mspenceree/Versa-Filter/hardware/README.md

# hardware

Schematic files in PDF and OrCAD (v10.3) format and Bill-of-Materials files in Microsoft Excel.
