mspenceree/Versa-Filter/hardware/BOM filter module.xls

Versa-Filter Module (Rev. B), Stock as of 5/23/2001
# Modules= |  |  | 100
 | pcs./ | pcs. | in stock |  |  |  |  |  |  | Quantity
Line | Mod. | total | at SPS | Ref. | Description | Manufacturer | Part# (if not in Desc.) | Distributor | Part# | Ordered | Price | Extended
1 | 4 | 400 | OK, in system | C1-4 | 10uF, 6.3V, Tantalum Chip Cap., Size 1206 | Panasonic | ESC-TOJY106R | Digi_Key | PCS1106CT orTR |  | 0.335 | $133.92
2 | 12 | 1200 | OK, in system | C5-16 | 0.1uF, 25V, +80, -20%, Chip Cap., Size 0603 | muRata | GRM39Y5V104Z025AD | Newark |  |  | 0.012 | $14.40
4 | 1 | 100 | >500 | J1 | IO_CONNECTOR (Custom break-away header) |  |  |  |  |  | 0.000 | $0.00
5 | 1 | 100 |  | J2 | JTAG_HEADER, 14 pin dual row header, gold (optional) |  |  | Digi_Key | S2011-36 |  |  | $0.00
6 | 1 | 100 | 100+68 | L1 | Ferrite Bead, 500mA, 600 Ohms, Size 0805 | Steward | HZ0805E601R | Digi_Key | 240-1018-1 |  | 0.069 | $6.93
8 | 1 | 100 | ~4000 | R1 | 100K, 1/16W, 5%, Chip Resistor, Size 0603 | Panasonic |  | Digi_Key | P100KGCT orTR |  | 0.015 | $1.50
9 | 3 | 300 | OK, in system | R2,3,RA | 10K, 1/16W, 5%, Chip Resistor, Size 0603 | Panasonic |  | Digi_Key | P10KGCT orTR |  | 0.013 | $4.05
10 | 1 | 100 | 119 | R4 | 2.2 Ohm, 1/10W, 5%, Chip Resistor, Size 0805 | Panasonic | ERJ-6RQJ2.2V | Digi_Key | P2.2BCT orTR |  | 0.112 | $11.20
12 | 1 | 100 | 105 | DA | Schottky Diode, 20V, 400mW, SMD | Diodes Inc. | SD103-CW | Digi_Key | SD103-CWDICT |  | 0.480 | $48.00
14 | 1 | 100 | ~370 | U5 | 12.288MHz Oscillator Module (SMD) | Epson | SG-636PCE-12.288MC2 | Digi_Key | SE2823CT orTR |  | 3.750 | $375.00
15 | 1 | 100 | 100+1 | U1 | TMS320C203PZ57 PZA57 or PZ80 OK, (TQFP), 16 bit DSP |  |  | Wyle |  |  | 7.680 | $768.00
16 | 1 | 100 | 64+37 | U2 | Am29F010-120EC (TSOP), 128K x 8 FLASH | AMD |  | Future | Avnet $3.90 |  | 3.500 | $350.00
17 | 2 | 200 | 205 | U3,U4 | IDT71256SA15PZ (TSOP), 32K x 8 SRAM | IDT |  | Insight |  |  | 3.000 | $600.00
18 | 1 | 100 | 101 | U6 | CS4218-KQ (TQFP), Stereo CODEC | Crystal |  | Insight |  |  | 7.000 | $700.00
19 | 1 | 100 | 110+36+1 | U7 | 74F00 (SOIC), Quad NAND gate | Fairchild, TI |  | Future | 74F00SC |  | 0.150 | $15.00
20 | 1 | 100 | 110+37+1 | U8 | 74ACT32 (SOIC), Quad OR gate | Fairchild, TI |  | Future | 74ACT32SC |  | 0.150 | $15.00
21 | 1 | 100 | 70+35+1 | U9 | 74FCT2652 (QSOP), Octal Reg. Transceiver | IDT, Pericom |  | Future | PI74FCT2652ATQ |  | 0.930 | $93.00
 |  |  |  |  |  |  |  |  |  |  |  | $0.00
23 | 1 | 100 | 400 |  | Blank PC Board | Valley Circuits, (818) 897-2006 |  |  |  |  | 8.000 | $800.00
24 | 1 | 100 | OK |  | Epoxy Compound | 3M | DP-270 black, 200ml |  |  |  | 2.500 | $250.00
 |  |  |  |  |  |  |  |  | Parts Total: |  |  | $4186.00
 |  |  |  |  |  |  |  |  | Parts Each Module: |  |  | $41.86
29 | 1 | 100 |  |  | PC board assembly cost (labor) |  |  |  |  |  | 6.900 | $690.00
30 | 1 | 100 |  |  | Final assembly cost (potting and labeling) |  |  |  |  |  | 20.000 | $2000.00
31 | 1 | 100 |  |  | Programming and Test cost (labor) |  |  |  |  |  | 30.000 | $3000.00
Rev. B Assembly notes: |  |  |  |  |  |  |  |  | Assembly Total: |  |  | $5690.00
1. Bake ICs to remove moisture as directed on packaging as necessary |  |  |  |  |  |  |  |  | Assembly Each Module: |  |  | $56.90
2. Trim plastic package of U3 or U4 so that pins will line up (if necessary)
3. Add 10K resistor (RA) from J2-pin 2 to J2-pin 4 (keep away from board edge) |  |  |  |  |  |  |  |  | Grand Total: |  |  | $9876.00
4. Add Schottky diode (DA) (SD103-CW) from top of C5 to top of R1 (cathode (line) to C5) |  |  |  |  |  |  |  |  | Each Module: |  |  | $98.76
5. Add jumper from W1-pad (near U2) to J1-pin 14
6. Add jumper from W2-pad (near U2) to J1-pin 18
7. Solder 28 pin IO connectors using supplied stand to assure alignment
