mspenceree/Versa-Filter/hardware/BOM filter system chassis.xls

Chassis Parts List for 2-Channel System (Rev. B), Stock as of 2/2001
# Systems = |  |  | 47
 | pcs./ | pcs. | in stock |  |  |  |  | Quantity
Line | each | total | at SPS | Description | Manufacturer & Part # | Distrib. | Part# | Ordered | Price | Extended
1 | 1 | 47 | 47 | Chassis box without panels | Elma (510) 656-0606, 33-05418-00 |  |  |  | 56.610 | $2660.67
2 | 1 | 47 | 97 | Front Panel, custom punched | Cresent Metal Products, (323) 465-1171 |  |  |  | 7.180 | $337.46
3 | 1 | 47 | 97 | Rear Panel, custom punched | Cresent Metal Products, (323) 465-1171 |  |  |  | 3.150 | $148.05
4 | 4 | 188 | 388 | 6-32 x 1/4" pan head screws (for PCB mounting) |  |  |  |  | 0.050 | $9.40
5 | 2 | 94 | 254 | 4-40 x 3/8" round head Philips screws (for power connector) |  |  |  |  | 0.050 | $4.70
6 | 2 | 94 | 294 | 4-40 nuts (for power connector) |  |  |  |  | 0.050 | $4.70
7 | 2 | 94 | >200 | 4-40 lock washers (for power connector) |  |  |  |  | 0.050 | $4.70
8 | 1 | 47 | 100+8 | DB-9F panel mount | AMP | Digi-Key | 209F |  | 0.520 | $24.44
9 | 1 | 47 | 100+9 | DB-9M panel mount | AMP | Digi-Key | 209M |  | 0.490 | $23.03
10 | 2 | 94 | 200+9 | Female screw locks for DB-9's (kit with nuts) | AMP | Digi-Key | A9005 |  | 1.050 | $98.70
11 | 1 | 47 | 100+5 | Power Switch | C&K, D502J125215SPQF | Digi-Key | CKC2010 |  | 0.360 | $16.92
12 | 1 | 47 | 100+5 | Power Connector, 5-pin DIN | CUI Stack, SD-50SN | Digi-Key | CP-1250 |  | 0.700 | $32.90
13 | 3 | 141 | 340 | 1N4005, 1A, 600V Diodes (reverse polarity protection) |  | Digi-Key | 1N4005GICT |  | 0.036 | $5.08
14 | 1 | 47 | OK | Hookup wire, #22AWG (7/30),3-whites,1-red,1-black,1-green,1-blue (7-wires, 14" each) |  | Digi-Key | A2016W-100 |  | 1.200 | $56.39
15 | 1 | 47 | 10 | Power Pack 115VAC to regulated 5V,-12V,+12V | Elpac, WM063-1950 | Digi-Key | EPS142 |  | 34.030 | $1599.41
16 | 1 | 47 | 51 | RS-232 cable, DB-9M to DB-9F |  | Digi-Key | AE1021 |  | 6.010 | $282.47
17 | 1 | 47 | 174 | Front panel adhesive labels | Adhesa Plate (800) 634-9701), AP16316 |  |  |  | 7.750 | $364.25
18 | 1 | 47 | 181 | Rear panel adhesive labels | Adhesa Plate (800) 634-9701), AP17398 |  |  |  | 4.200 | $197.40
19 | 4 | 188 | 78 | 6-32 x 1/2" standoffs (for PCB mounting. 8 and 32 ch systems only) |  | Mouser | 534-2210 |  |  | $0.00
20 | 4 | 188 | 49 | 6-32 x 1/4" flat head screws (for panel standoffs. 8 and 32 ch systems only) |  |  |  |  |  | $0.00
21
22 | 1 | 47 | - | Assembly cost (chassis wiring labor) |  |  |  |  | 4.000 | $188.00
23 |  |  |  |  |  |  | Chassis Total: |  |  | $6058.66
24 |  |  |  |  |  |  | Each System: |  |  | $128.91
