mspenceree/Versa-Filter/hardware/BOM filter system.xls

2-Channel Versa-Filter System ( Rev. B), Stock as of 2/2001
# of Boards = |  |  | 98
 | pcs./ | pcs. | in stock |  |  |  |  |  | Quantity
Line | each | total | at SPS | Reference | Description | Manufacturer & Part # | Distrib. | Part# | Ordered | Price | Extended
1 | 4 | 392 | 4000+5 | C18,23,28,33 | 100pF, Size 0603 |  | Digi-Key | PCC101ACVCT |  | 0.019 | $7.45
2 | 2 | 196 | 204+4 | C20,30 | 470pF, Size 0603 |  | Allied | 213-0185 |  | 0.297 | $58.21
3 | 2 | 196 | 198 | C19,29 | 2200pF, Size 0603 |  | Allied | 213-1514 |  | 0.182 | $35.67
4 | 4 | 392 | 500+3 | C4,5,7,35* | 0.01uF, Size 0603 (C35 is for serial port fix) |  | Digi-Key | PCC103BVCT |  | 0.132 | $51.74
5 | 14 | 1372 | 4000+~1000 | C9*,10*,11*,12,13*,14*,15,16,21,24,25,26,31,34 | 0.1uF, Size 0603 |  |  |  |  | 0.012 | $16.46
6 | 2 | 196 | 196 | C22,32 | 0.1uF 10%, Size 1206 or 1210 |  | Allied | 213-0185 |  | 0.594 | $116.42
7 | 2 | 196 | 216 | C17,27 | 1.8uF, 16V, Size 1206 or 1210 |  | Digi-Key | PCC???CT |  | 0.562 | $110.25
8 | 2 | 196 | 1475+4 | C6,8* | 10uF, 6.3V, Size 1206 or 1210 |  | Digi-Key | PCS1106CT |  | 0.480 | $94.08
9 | 2 | 196 | 246 | C1,2 | 68uF, 16V, Size 7.3 x 4.3 mm |  | Allied | 926-0411 |  | 1.870 | $366.52
10 | 1 | 98 | 98 | C3 | 100uF, 6.3V, Size 7.3 x 4.3 mm |  | Allied | 213-1074 |  | 1.584 | $155.23
11
12 | 1 | 98 | 202 | R10 | 10.2, 1/8W, 1%, Resistor, Size 1206 |  | Digi-Key | P10.2FCT |  | 0.126 | $12.35
13 | 3 | 294 | 1000+44 | R3,17,29 | 100, 1/16W, 1%, Resistor, Size 0603 |  | Digi-Key | P100HCT |  | 0.126 | $37.04
14 | 2 | 196 | 300+4 | R8,9 | 221, 1/16W, 5%, Resistor, Size 0603 |  | Digi-Key | P221HCT |  | 0.126 | $24.70
15 | 2 | 196 | 300 | R20,32 | 2K, 1/16W, 1%, Resistor, Size 0603 |  | Digi-Key | P2.00KHCT |  | 0.126 | $24.70
16 | 12 | 1176 | 1850+~1000 | R1,2,4,5,6,7,11*,12*,16,23,28,35 | 10K, 1/16W, 1%, Resistor, Size 0603 |  | Digi-Key | P10.0KHCT |  | 0.126 | $148.18
17 | 4 | 392 | 1000+7 | R15,18,27,30 | 20K, 1/16W, 1%, Resistor, Size 0603 |  | Digi-Key | P20.0KHCT |  | 0.126 | $49.39
18 | 4 | 392 | 1000+5 | R14,22,26,34 | 68.1K, 1/16W, 1%, Resistor, Size 0603 |  | Digi-Key | P68.1KHCT |  | 0.126 | $49.39
19 | 4 | 392 | 1000+4 | R13,21,25,33 | 169K, 1/16W, 1%, Resistor, Size 0603 |  | Digi-Key | P169KHCT |  | 0.126 | $49.39
20 | 2 | 196 | 300+3 | R24,36 | 301K, 1/16W, 1%, Resistor, Size 0603 |  | Digi-Key | P301KHCT |  | 0.126 | $24.70
21 | 2 | 196 |  | R19,31 | Rg, 1/16W, 1%, Resistor, Size 0603 (optional) |  |  |  |  |  | $0.00
22 | 1 | 98 | 98+4 | RP1 | 10K trim pot | Bourns 3329H-1-103 | Digi-Key | 3329H-103 |  | 1.323 | $129.65
23
24 | 2 | 196 | 200+51 | D1,5* | Dual Schottky (com. cathode) SOT-23 |  | Digi-Key | BAT54CCT |  | 0.930 | $182.28
25 | 1 | 98 | 100+5 | D4 | Dual Schottky (com. anode) SOT-23 |  | Digi-Key | BAT54ACT |  | 0.930 | $91.14
26 | 2 | 196 | 200+8 | D2,3 | LED's, 3.7mm, Red | HLMP-1301 | Allied | 782-0015 |  | 0.297 | $58.21
27
28 | 1 | 98 | 95 | U1* | MAX232ACSE, SO-16 | Maxim | Digi-Key | MAX232ACSE |  | 1.230 | $120.54
29 | 2 | 196 | 200+2 | U3,5 | Instrumentation Amp (INA128or129),SO-8 | Burr Brown | Digi-Key | INA128U |  | 3.620 | $709.52
30 | 2 | 196 | 201 | U4,6 | Dual Op Amp (OPA2134), SO-8 | Burr Brown | Digi-Key | OPA2134UA |  | 2.670 | $523.32
31
32 | 4 | 392 | 393 | J2,3,5,6 | BNC Vertical Mount | A/D Electronics (253) 851-8005, 581-002-00 |  |  |  | 2.500 | $980.00
33 | 1 | 98 | 7 | P1 (note 1) | DB-9F PC board Mount |  | Digi-Key | 509F |  | 1.930 | $189.14
34 | 1 | 98 | 6 | P2 (note 1) | DB-9M PC board Mount |  | Digi-Key | 509M |  | 1.340 | $131.32
35 | 1 | 98 | OK | - | Header for mounting LC Display (15 pin) |  | Digi-Key | S1212-15 |  | 0.030 | $2.94
36 | 2 | 196 | OK | JP2,4 | Jumper header (2 pin) (Use strips of 36 pins and cut) |  | Digi-Key | S1212-36 |  | 0.071 | $13.94
37 | 2 | 196 | OK | JP3,5 | Jumper header (3 pin) ( " ) |  | Digi-Key | S1212-36 |  | 0.107 | $20.91
38 | 4 | 392 | 406 | - | Shorting Jumpers |  | Digi-Key | S9000 |  | 0.093 | $36.46
39 | 2 | 196 | 63 | J1,4 (note 2) | 1/4 inch Phone Jack | SwitchCraft | Digi-Key | SC1096 |  | 1.711 | $335.36
40 | 1 | 98 | 100+4 | LS1 | Loud Speaker | Panasonic, EAF-14R06C | Digi-Key | P9922 |  | 3.610 | $353.78
41 | 1 | 98 | 98 | S1 | Rotory Encoder with SW (15puls, 30 det) | Switch Channel (323) 221-8876, RE11CT-V1Y12-EF2CS |  |  |  | 1.290 | $126.42
42 | 1 | 98 | 12 | M1 | Versa-Filter Module | SPS, VF20-2 ($495 retail) |  |  |  | 100.00 | $9800.00
43 | 1 | 98 | 98+3 | U2 | LC Display (16 character x 1 line) | Apollo Display (888) 452-3937, Oprex, DMC-16105NY-LY (or Digi-Key 73-1018) |  |  |  | 14.680 | $1438.64
44 | 1 | 98 | 129 | - | Versa-Filter module socket-leave spacing | SAMTEC, BCS-128-L-S-HE |  |  |  | 2.373 | $232.55
45 | 1 | 98 | 64 | - | Knob & Cap (for rotory encoder) | Selco (714)-712-6200, DA210-006BLACK & C210BLACK |  |  |  | 0.960 | $94.08
46 | 1 | 98 | 198 | - | Blank PC Board | Valley Circuits, (818) 897-2006 |  |  |  | 7.00 | $686.00
47 |  |  |  |  |  |  |  | Parts Total: |  |  | $17688.07
48 |  |  |  |  |  |  |  | Parts Each Board: |  |  | $180.49
49
50 | 1 | 98 | - |  | PC board assembly cost (labor) |  |  |  |  | $10.00 | $980.00
51 | 1 | 98 | - |  | Testing cost (labor) |  |  |  |  | $20.00 | $1960.00
52 |  |  |  |  |  |  |  | Assembly Total: |  |  | $2940.00
53 |  |  |  | * - RS-232 related circuits (required for Evaluation board and 2ch. Versa-Filter System board) |  |  |  | Assembly Each Board: |  |  | $30.00
54 |  |  |  | note 1 - DB-9s required for Evaluation board only (not on 2ch. Versa-Filter System board)
55 |  |  |  | note 2 - Differential input connectors (option) |  |  |  | Grand Total: |  |  | $20628.07
56 |  |  |  |  |  |  |  | Total Each Board: |  |  | $210.49
