mspenceree/Versa-Filter/(list of files, cad)

Other CAD files:
firmware/builds/FILTASM.OBJ
firmware/builds/FILT.OBJ
