mspenceree/Versa-Filter/hardware/filter_module.pdf

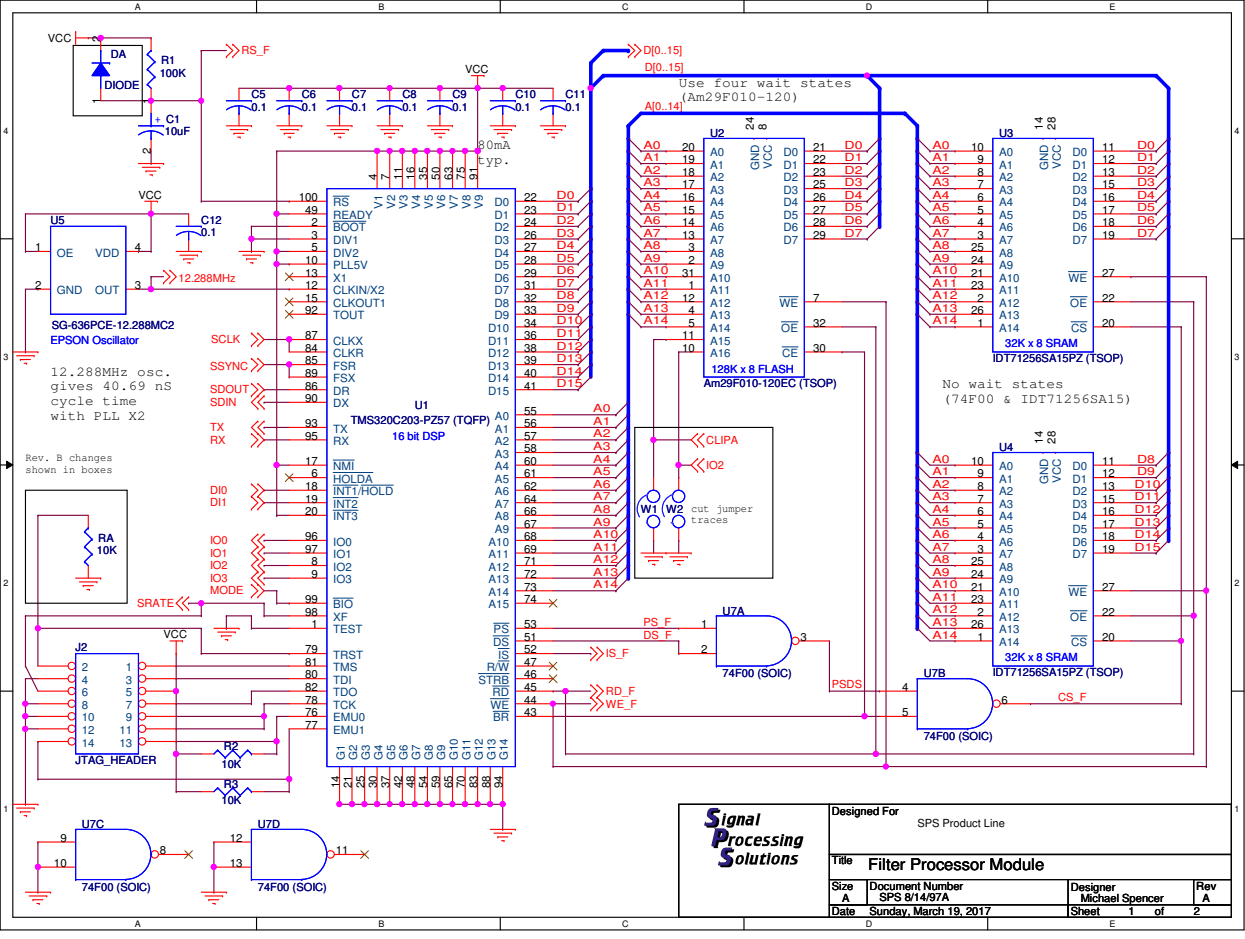
[picture p5: page 1]

Use four wait states

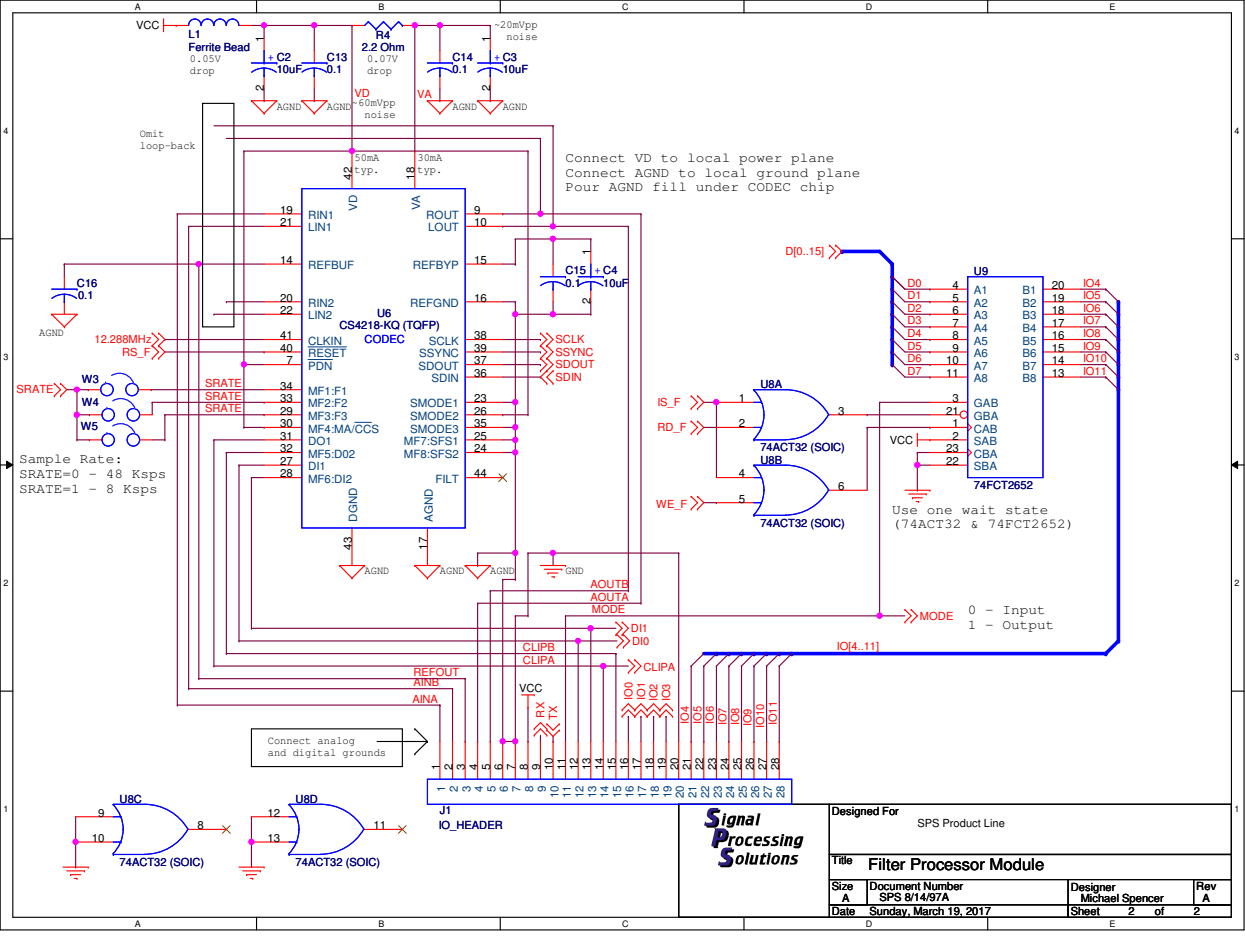
[picture p6: page 2]

Connect VD to local power plane
Connect AGND to local ground plane
Pour AGND fill under CODEC chip

Use one wait state
(74ACT32 & 74FCT2652)

GND AOUTB

AOUTA

CLIPB
CLIPA
