mspenceree/Versa-Filter/hardware/filter_system.pdf

# Versa-Filter Module

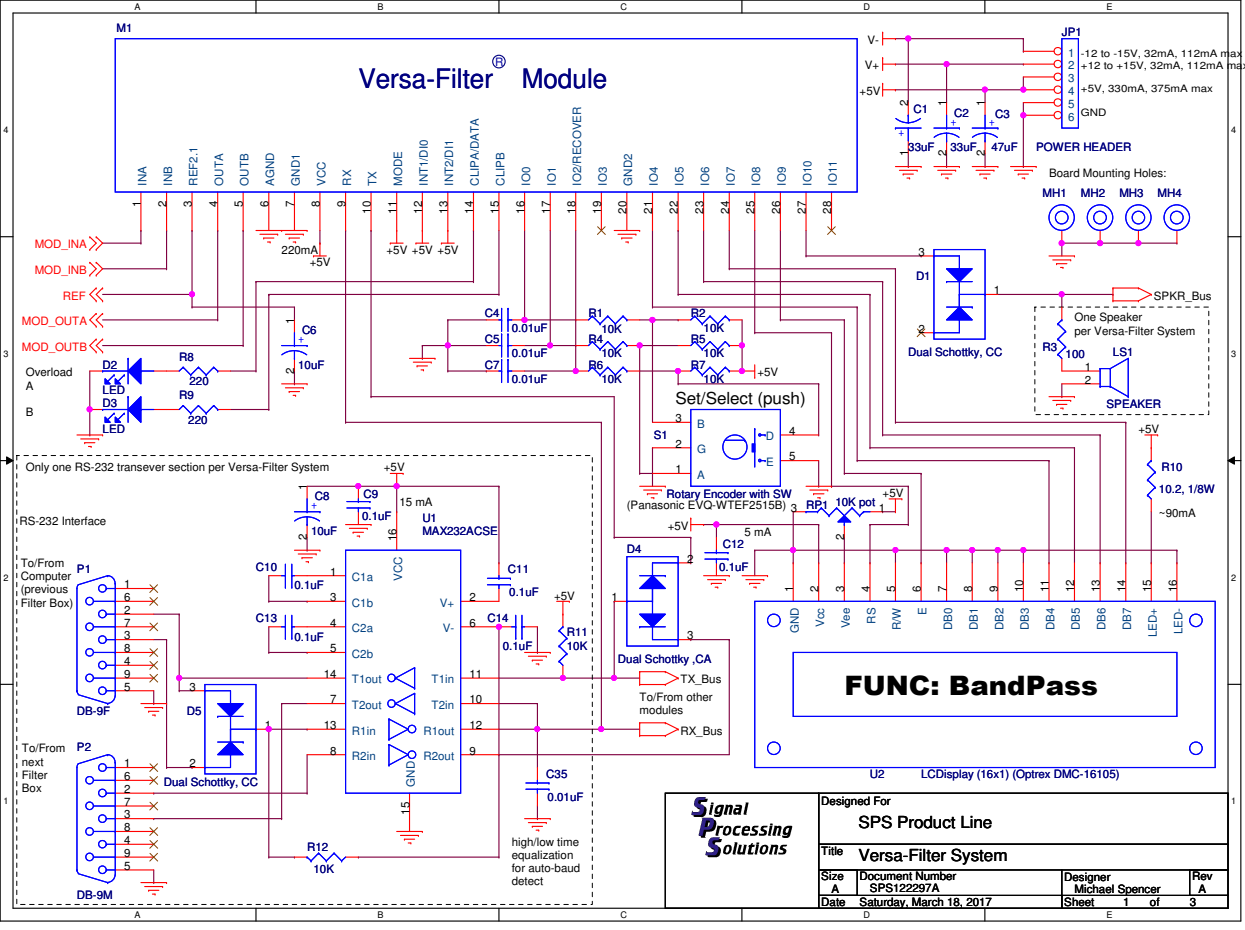
[picture p7: page 1]

Board Mounting Holes:

One Speaker
per Versa-Filter System

Only one RS-232 transever section per Versa-Filter System

V+V-

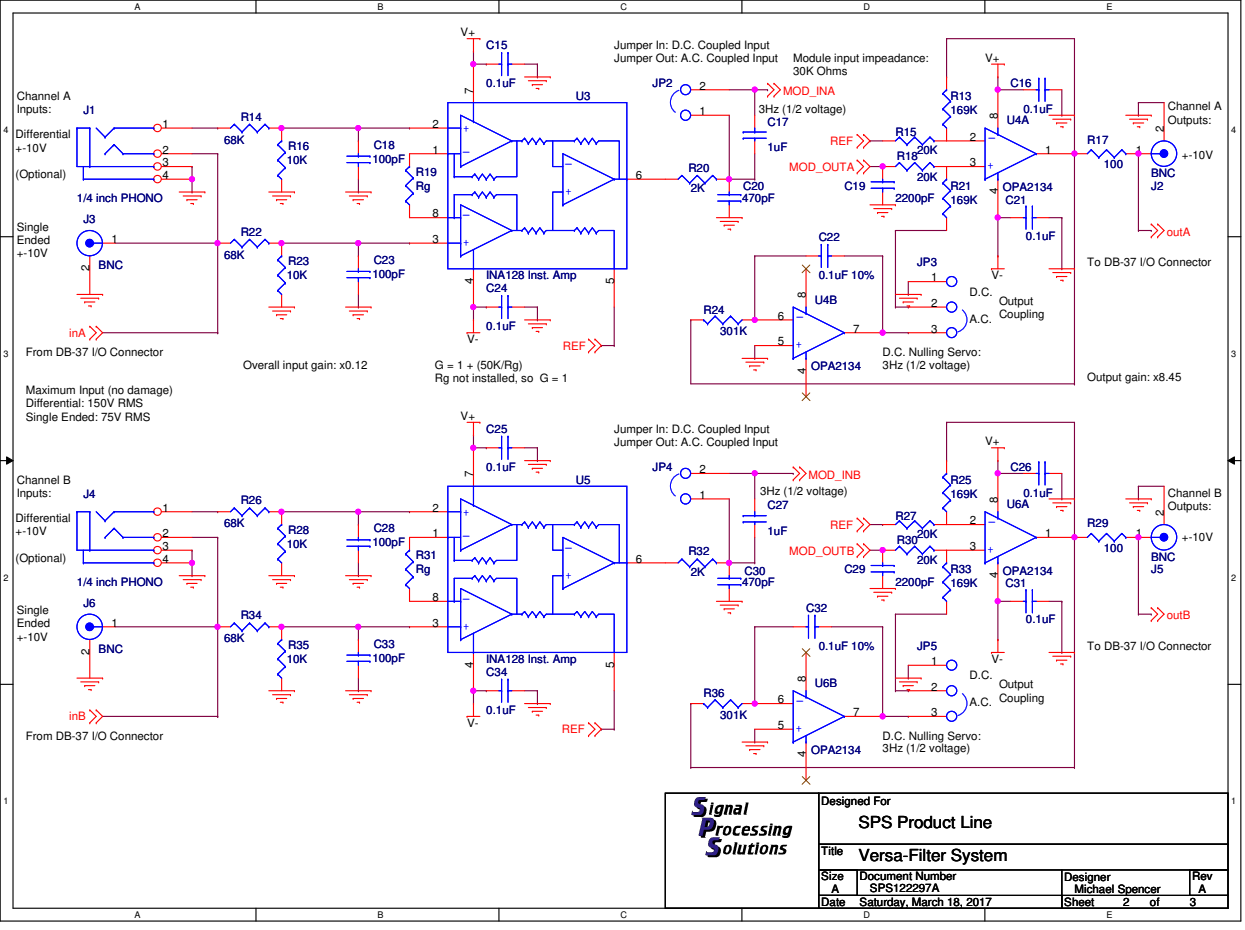
[picture p8: page 2]

Jumper In: D.C. Coupled Input
Jumper Out: A.C. Coupled Input

Rg not installed, so G = 1

Maximum Input (no damage)
Differential: 150V RMS
Single Ended: 75V RMS

inA1 inA3 inA5 inA7 inA9 inA11 inA13 inB1 inB3 inB5 inB7 inB9 inB11 inA15 inB13 inB15 outA outB outA3 outA5 outA7

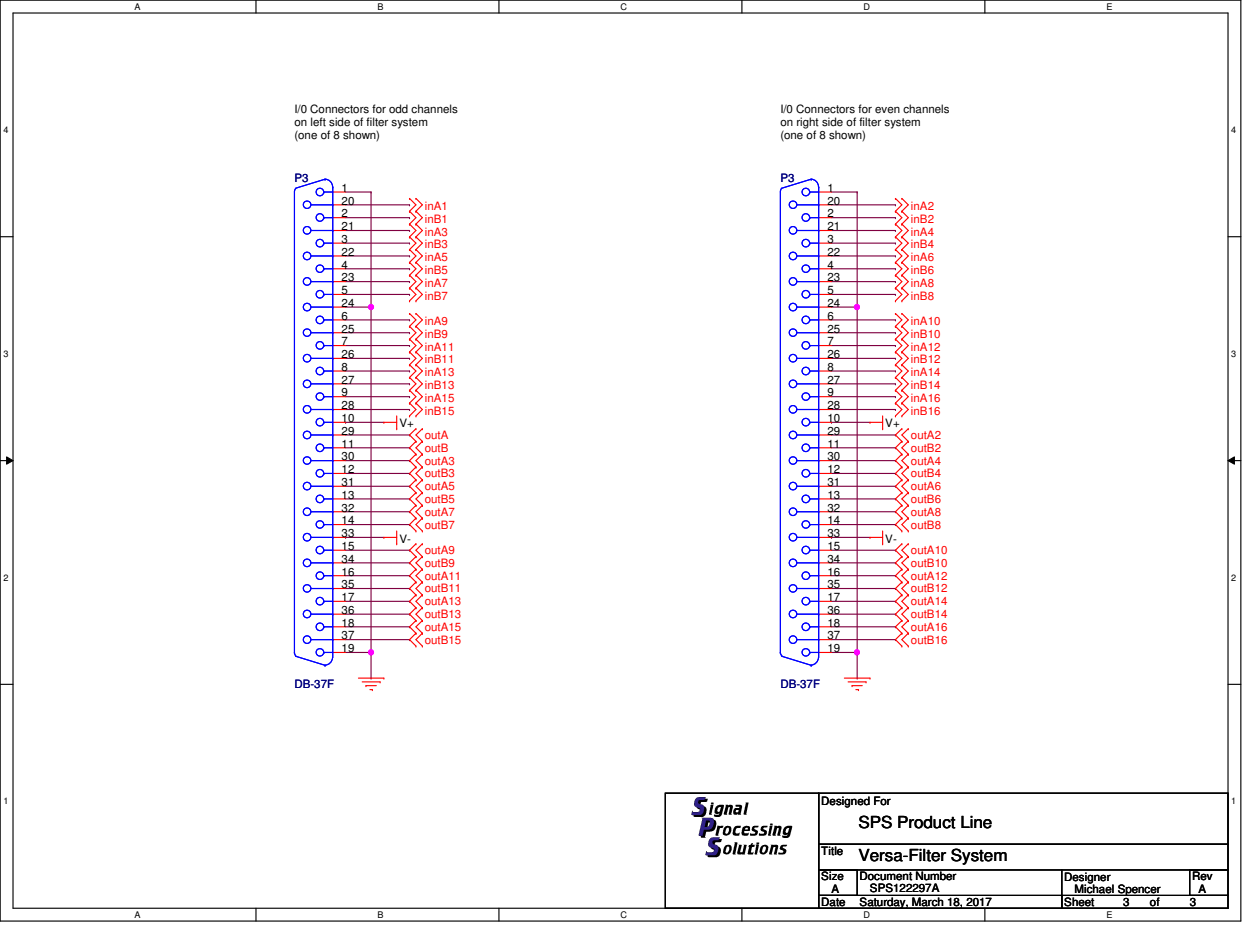
[picture p9: page 3]
outA9; outA11; outA13; outA15; outB3; outB5; outB7; outB9; outB11; outB13; outB15; inA2; inA4; inA6; inA8; inA10; inA12; inA14; inB2; inB4; inB6; inB8; inB10; inB12; inA16; inB14; inB16; outA2 outB2 outA4; outA6; outA8; outA10; outA12; outA14; outA16; outB4; outB6; outB8; outB10; outB12; outB14; outB16; Size; Document Number; Rev; Designer; Saturday, March 18, 2017

I/0 Connectors for odd channels
on left side of filter system
(one of 8 shown)

I/0 Connectors for even channels
on right side of filter system

Designed For
SPS Product Line

Title
Versa-Filter System
