mspenceree/Versa-Filter/(list of files, drawings)

Other design files:
hardware/FILTER_MODULE.DSN
hardware/FILTER_SYSTEM.DSN
