mspenceree/Versa-Filter/firmware/filt.c

/**************************************************************************
 *
 *  filt.c source file
 *
 *  This c source file contains code for the filter module.
 *  It performs initialization, sets up ISRs and enters main loop and
 *  flashes cursor until action is required.
 *
 *  History:
 *  V1.00   10/3/97 Started coding orignial - Michael Spencer
 *  V1.01 to V1.60  Lots of additions and modifications...
 *  V1.61   1/24/99 Commented out the command display test lines
 *  V1.62   1/31/99 Fixed the "valid_serial()" func. to compute correct check sums
 *  V1.63   2/6/99  Added the "display:" option that brings back the normal display
 *  V1.64   2/9/99  Added serial command interface
 *  V1.65   2/28/99 Re-aranged sign-on message so recall 0 is not delayed
 *  V1.66   3/13/99 Added display of UserFIR coefs.
 *  V1.67   3/14/99 Added value checking on RS-232 paramters
 *  V2.00   4/26/00 Added calibration msg. This is the feature complete version.
 *  V2.10   4/26/00 Added support for alternate (direction reversed) rotary encoder.
 *  V2.20   6/8/01  Fixed error in parser that updates min_value and max_value limits (param_ptr_temp).
 *                  Removed "Calibrate". Added "Erase Mem".
 *
 **************************************************************************/

/******* Build Parameters *************************************************/
#define MAIN 1              /* 1 - builds main (normal) version of Firmware */
                            /* 0 - builds recovery version of Firmware with */
                            /*     with only serial port programming support */
#define ENCODER_TYPE    1   /* Rotary encoder type: 0 - panasonic, 1 - Switch Channel */
#define SIGN_ON_FLAG_Versa_Filter   1   /* set to one for standard sign on message */
#define SIGN_ON_FLAG_AccuQuest      0   /* set to one for AccuQuest sign on message */

/******* Program Parameters ***********************************************/
#define VERSION 220             /* Firmware Version # (3 digit#: 123 = V1.23) */
#define CURSOR_PERIOD 50        /* cursor flashing period (in multiples of 10ms) */
/*#define HOLD_TIME 300         /* hold time for push/hold to become active (in multiples of 10ms) */
#define OVERFLOW_STICK 20       /* overload LED stick time (on after overload) (in multiples of 5ms) */
#define VU_DECAY 2              /* decay time between 6dB decrements of VU Meter (in multiples of 5ms) */
#define SENDSN_WAIT 22          /* (~0.75sec.) max wait time for sendsn command (in multiples of 32767us) */
#define SW_DEBOUNCE  500            /* switch/encoder debounce interval in us (set to ~1000) */
#define SERIAL_BUF_LEN 128          /* (128) length of serial input command buffer (MUST BE POWER OF 2) */
/* #define ORDER_MIN 2              /* minimum FIR filter order */
/* #define ORDER_MAX 127            /* maximum FIR filter order */
#define FCUT_MIN    200.0/48000.0   /* 600 minimum cutoff freq. for LP and HP (fraction of sampling rate) */
#define FCUT_MAX    20000.0/48000.0 /* 19200 maximum cutoff freq. for LP and HP (fraction of sampling rate) */
#define F1_MIN      200.0/48000.0   /* 600 minimum f1 freq. for LP and HP (fraction of sampling rate) */
#define F1_MAX      19600.0/48000.0 /* 18200 maximum f1 freq. for LP and HP (fraction of sampling rate) */
#define F2_MIN      600.0/48000.0   /* 1600 minimum f2 freq. for LP and HP (fraction of sampling rate) */
#define F2_MAX      20000.0/48000.0 /* 19200 maximum f2 freq. for LP and HP (fraction of sampling rate) */
#define FWIDTH_MIN  400.0/48000.0   /* 1000 minimum width of BP filter (fraction of sampling rate) */
#define FNFNOTCH_MIN  200.0/48000.0     /* 300 minimum freq of notch filter (fraction of sampling rate) */
#define FNFNOTCH_MAX  20000.0/48000.0   /* 19200 maximum freq of notch filter (fraction of sampling rate) */
#define FNFWIDTH_MIN  10.0/48000.0      /* 10 minimum width of notch filter (fraction of sampling rate) */
#define FNFWIDTH_MAX  10000.0/48000.0   /* 10000 maximum width of notch filter (fraction of sampling rate) */
#define GAIN_MAX    10000       /* maximum gain: 100 */
#define LAST_MEM_LOC 4          /* last memory loction for store and recall functions
                                   (9 max because of retrieved_flag[] ) */

/*#define FIR_LENGTH 256    /* temp */

#define SERIAL_LOC  0x0040      /* location of serial number in code space */
#define XTAL        12.288e6    /* frequency of DSP crystal */
#define FLASH_WAITS 4           /* Number of FLASH memory wait states (7 max.) */
#define IO_WAITS    1           /* Number of I/O wait states (7 max.) */
/*#define CLKOUT1       2.0*XTAL    /* frequency of master DSP clock = (1/cycle time) */
/*#define PSCPERIOD (16.0*1e6)/(CLKOUT1) /* set the period out of the prescaler (in microseconds) */
/*#define LOG2D4    0.0752574989    /* log10(2)/4 for computing ideal calibration constants */
#define PI  3.14159265359
#define PID2 1.5707963268        /* PI/2 */
#define PIT2 6.28318530717959   /* PI*2

/***** Define complex data type *******************************************/
/* typedef struct FCOMPLEX {float r,i;} fcomplex;   /* define the fcomplex structre for complex arithmetic */

/***** Include files here *************************************************/
#include    "c203.h"    /* Include useful constants and macros for the TMS320C203 */
#include    <stdlib.h>  /* Include standard library header */
#include    <math.h>    /* Include math library header */
#include    <string.h>  /* Include string function header */
#include    <ctype.h>   /* Include character function header */
#include    <limits.h>  /* define LONG_MIN and LONG_MAX */
#include    "filt.h"    /* generated by filt.m */

/***** Globals ************************************************************/

/* Define arrays of string pointers for text menus: */
/* (note: C stores duplicate string constants throughout the program only once!) */
/* Basic function strings: */
char *func_text[]={
    "NoFunc     ",
    "AllPass    ",
    "LowPass    ",
    "HighPass   ",
    "BandPass   ",
    "BandStop   ",
    "Notch      ",
    "InvNotch   ",
    "UserFIR    ",
/*  "Sine       ", */
    ""
    };
/* Parameter label strings: */
char *revertolevels_text[]={
    "N",
    "Y",
    ""
    };
char *samplerate_text[]={
    " 8KHz",
    "48KHz",
    ""
    };
char *inputsrc_text[]={
    "Analog ",
    "WtNoise",
    ""
    };      
char *mode_text[]={
    "A&B Common ",
    "A&BSeparate",
    "Ch A Only  ",
    ""
    };
char *cascade_ch_a_b_text[]={
    "N",
    "Y",
    ""
    };
char *master_mode_text[]={
    "N   ",
    "Y   ",
    ""
    };
char *initialize_text[]={
    "press",
    ""
    };
char *null_text[]={
    ""
    };

/* Define data-structure array that holds all system parameters: param_struct[]
 *
 *  .text   - pointer to parameter-string that is displayed on the LCD.
 *            Embed numbers in text as follows: ### - int, ###._# -float
 *            The "_" is the first curssor position in the number. It controls
 *            the increment/decrement step size.
 *
 *  For "text  text" display:
 *  .flag   - flag bits = 1pss ss-- nnnn nnnn
 *  .label  - unsinged integer that points to the first parameter label string pointer
 *
 *  For "text int" and "text float" displays:
 *  .flag   - flag bits = 0pss ssoo olll lfff
 *  .label  - Not used
 *
 *  where: d =          derived parameter bit, set if param. is derived from other params (not used now)
 *         p =          press flag bit (signals that this is a press/hold param.)
 *         ssss =       (nstart) start display position for right hand label text or number
 *         nnnn nnnn =  number of parameter label text strings for this param
 *         ooo =        (n_offset) first cursor position in number (relative to ssss) (marked by "_", eg. "##_.#")
 *         llll =       (nlength) length of displayed number
 *         fff =        number of fractional digits to display to right of "."
 *                      if fff=0 the number is assumed an interger
 *
 *  note: ssss, nnnn nnnn, llll, and fff are initialized in the initialize() function
 *        based on the text strings entered in the structure definition below.
 *        The p needs to be initialized in structure definition.
 */

struct pstruct {
  char *text;
  unsigned int flag;
  unsigned int label;
  };

struct pstruct param_struct[]={
/*  0 */    {" FUNC:",          0, (unsigned int)func_text},
 
/* Options: */ 
/*  1%*/    {"Levels-In  Out  ",0, (unsigned int)null_text},
/*  2 */    {"RevertToLevels:", 0, (unsigned int)revertolevels_text},
/*  3 */    {"FullScalIn:#_Vpp",0, 0},
/*  4 */    {"SampleRate:",     0, (unsigned int)samplerate_text},
/*  5 */    {"InputSrc:",       0, (unsigned int)inputsrc_text},
/*  6 */    {"Mode:",           0, (unsigned int)mode_text},
/*  7 */    {"Cascade Ch A&B:", 0, (unsigned int)cascade_ch_a_b_text},
/*  8 */    {"Master Mode:",    0, (unsigned int)master_mode_text},
/*  9%      {"Calibrate:",      0x4000, (unsigned int)calibrate_text}, */
/*  9%*/    {"Initialize:",     0x4000,  (unsigned int)initialize_text},
/* 10 */    {"Store:  # press ",0x4000, 0},
/* 11 */    {"Recall: # press ",0x4000, 0},
/* 12%*/    {"Firmware:  V",    0, (unsigned int)null_text},
/* 13%*/    {"Serial No:",      0, (unsigned int)null_text},

/* Function Parameters: */ 
/* 14 */    {" NFgain:###_.##x",0, 0},

/* 15 */    {" APgain:###_.##x",0, 0},

/* 16 */    {" LPfcut: #####Hz",0, 0},
/* 17 */    {" LPorder:    ###",0, 0},
/* 18 */    {" LPgain:###_.##x",0, 0},

/* 19 */    {" HPfcut: #####Hz",0, 0},
/* 20 */    {" HPorder:    ###",0, 0},
/* 21 */    {" HPgain:###_.##x",0, 0},

/* 22 */    {" BPf1:   #####Hz",0, 0},
/* 23 */    {" BPf2:   #####Hz",0, 0},
/* 24 */    {" BPfcntr:#####Hz",0, 0},
/* 25 */    {" BPfwdth:#####Hz",0, 0},
/* 26 */    {" BPorder:    ###",0, 0},
/* 27 */    {" BPgain:###_.##x",0, 0},

/* 28 */    {" BSf1:   #####Hz",0, 0},
/* 29 */    {" BSf2:   #####Hz",0, 0},
/* 30 */    {" BSfcntr:#####Hz",0, 0},
/* 31 */    {" BSfwdth:#####Hz",0, 0},
/* 32 */    {" BSorder:    ###",0, 0},
/* 33 */    {" BSgain:###_.##x",0, 0},

/* 34 */    {" Nfnotch:#####Hz",0, 0},
/* 35 */    {" Nfwidth:#####Hz",0, 0},
/* 36 */    {" Ngain: ###_.##x",0, 0},

/* 37 */    {" INfcntr:#####Hz",0, 0},
/* 38 */    {" INfwdth:#####Hz",0, 0},
/* 39 */    {" INgain:###_.##x",0, 0},

/* 40 */    {" UForder:    ###",0, 0},
/* 41 */    {" UFtap:##_      ",0, 0},  /* fix: 0x4000 */
/* 42 */    {" UFgain:###_.##x",0, 0},

/* 43 */    {" Sfreq:#####.#Hz",0, 0},
/* 44 */    {" Sphase:###.#deg",0, 0},
/* 45 */    {" Samp:   ###_.##",0, 0},

            };
/* % - memory not used */

/* Setup pointers to parameter boundaries: */
int param_ptr_start[]={14, 15, 16, 19, 22, 28, 34, 37, 40, 43};
int param_ptr_end[]=  {14, 15, 18, 21, 27, 33, 36, 39, 42, 45}; /* this should always be the gain parameter */

#define OPTIONS_START   1
#define OPTIONS_END     13

#define NPARAMSTRUCT    (sizeof param_struct)/(sizeof param_struct[0])
#define NPARAMS         NPARAMSTRUCT + 128      /* reserve additional space for user filter coefs. */
#define NPARAMSM6       NPARAMS + NPARAMS + NPARAMS + NPARAMS + NPARAMS + NPARAMS

/* define the array that holds all parameter values and user filter coefs. */
long params[NPARAMS][3];


/* Access the parameters depending on the display type:
 *
 * For "text text" display, access as follows:
 *    pointer to parameter text= param_struct[param_ptr].text
 *    flag value =                  param_struct[param_ptr].flag
 *    pointer to label text = (char*)(*(char*)(param_struct[param_ptr].label + (parameter value)))
 *
 * For "text int" and "text float" displays, access as follows:
 *    pointer to parameter text=    param_struct[param_ptr].text
 *    flag value =                  param_struct[param_ptr].flag
 *
 * For params[][]:
 *    parameter value for A =       params[param_ptr][0]
 *    parameter value for B =       params[param_ptr][1]
 *    parameter value for Common =  params[param_ptr][2]
 *
 * Filter coeficients are stored from params[NPARAMSTRUCT][] to params[NPARAMSTRUCT + 128][]
 * and packed into params[][] 2 coefs per location: odd (MS 16 bits), even coef (LS 16 bits).
 *
 */


/********* Globals Variables (values set in initialize()) ********************/
unsigned int port0_copy;
unsigned flash_data[0x2000];    /* (8192 bytes) used to hold data to program the FLASH */
int sw_down, sw_down_old, sw_pressed, sw_released; /* used by txrxint_c */
int gray_code, gray_code_old, cw, ccw, testcount;
int flash_locked;   /* lock programming of FLASH memory when set */
int cursor_pos, cursor_pos_vu, cursor_flag, flash_cursor_flag, down_turn_flag, press_flag;
int param_ptr, write_ptr, read_ptr, p_state, flag_options;
int index_ab;           /* flag to specify current menu state:
                        0 - function A
                        1 - function B
                        2 - function A&B (Common)
                        0 - Options section (and flag_options==1)                   */
int params_changed;     /* flag to indicate how params chaged:
                        0 - no change
                        1 - param_ptr changed (update only min_value and max_value)
                        2 - parameter has changed
                        3 - button press action has been confirmed                  */
int params_changed_copy;
int led_counter, vu_counter;
int max_in_level;   /* used to hold calibration constant */
long min_value, max_value;  /* used to limit min and max values of current parameter */
long p_long, p_sum, serial_number;  /* used in the parse function: */
unsigned p_uint1, p_uint2;
int sn_ok_flag, quietsn_flag;
int serial_error_flag;
unsigned data_count;
int sign_mult, index_ab_p;
long check_sum;
unsigned func_addr_temp_a, func_addr_temp_b;
float fsample;  /* current sampling rate in Hz*/
char serial_str[11];    /* serial number string of module (including check sums and terminating null) */
char serial_in_buf[SERIAL_BUF_LEN]; /* RS-232 serial input buffer */
char parameter_str[17], value_str[17];  /* used by cammand parser to hold incomming command strings */
char vu_chars[]={' ', 8, 9, 10, 11, 12, 13, 14, 15, 'X', 'X', 'X', 'X'};    /* used by vu_update() */
unsigned gopt_a, gopt_b, aopt_a, aopt_b;    /* optimal CODEC gain and attenuation settings */
unsigned in_a_vu_level, in_b_vu_level, out_a_vu_level, out_b_vu_level;
float scale_k_a, scale_k_b;
int auto_vu_count;
int iorder_old;
float window[128];      /* holds first half of pre-computed modified-Blackman-window */

#define RECORD_LENGTH   6 + NPARAMSM6       /*  Set to (6 + 6*NPARAMS) = (6 + 6*(46+128)) = 1050 */
unsigned record[RECORD_LENGTH];

/* float in_cal_levels_a[16], in_cal_levels_b[16], out_cal_a[32], out_cal_b[32];

    
/********* Globals pointers used for internal data RAM access: *****/
volatile unsigned int *imr_ptr, *greg_ptr, *ifr_ptr;

/***** External Variables to access assembly variables ********************/
extern int k7f00h, kf80fh, kfff0h;
extern int in_a, in_b, out_a, out_b, t_reg_scale_a, t_reg_scale_b, assembly_flag;
extern int in_a_hold, in_b_hold, out_a_hold, out_b_hold;
extern unsigned in_error, in_error_stick, in_digital, out_gain, out_atten, iosr_copy;
extern unsigned func_addr_a, func_addr_b, coef_ptr_a, coef_ptr_b, data_ptr_a, data_ptr_b;
extern unsigned orderm2_a, orderm2_b;
extern int fir_coef[256], coefdata[256];

/********* define I/O port variables **************************************/
ioport  unsigned    port0;      /* I/O port pins IO4-IO11 on module */
ioport  unsigned    portffe8;   /* CLK I/O address */
ioport  unsigned    portffec;   /* ICR I/O address */
ioport  unsigned    portfff0;   /* SDTR I/O address */
ioport  unsigned    portfff1;   /* SSPCR I/O address */
ioport  unsigned    portfff4;   /* ADTR I/O address */
ioport  unsigned    portfff5;   /* ASPCR I/O address */
ioport  unsigned    portfff6;   /* IOSR I/O address */
ioport  unsigned    portfff7;   /* BRD I/O address */
ioport  unsigned    portfff8;   /* TCR I/O address */
ioport  unsigned    portfff9;   /* PRD I/O address */
ioport  unsigned    portfffa;   /* TIM I/O address */
ioport  unsigned    portfffc;   /* WSGR I/O address */

/***** Declare external assembly functions ********************************/
extern void no_func_a(void);
extern void no_func_b(void);
extern void allpass_func_a(void);
extern void allpass_func_b(void);
extern void iir_4_a(void);
extern void iir_4_b(void);
extern void fir_15_a(void);
extern void fir_15_b(void);
extern void fir_16_a(void);
extern void fir_16_b(void);
extern void lattice_2_a(void);
extern void lattice_2_b(void);
extern void lattice_4_a(void);
extern void lattice_4_b(void);
extern void lattice_8_a(void);
extern void lattice_8_b(void);
extern void notch_a(void);
extern void notch_b(void);
extern void get_serial();

/***** Function Prototypes ************************************************/
void txrxint_c(void);
int inc_dec_param_ptr(void);
void inc_dec_mod(int *ptr, int mod);
void add_sub_pow(long *ptr, int pow);
void initialize(void);
void set_fsample(void);
void init_params(void);
void init_freq_params(void);
void reset_port(void);
void sign_on(void);
void reset_lcd(void);
void update_disp_left(void);
void update_disp_right(int pos);
void disp_text(char *text, int position, int cursor_on);
void disp_num(long num, int position, int width, int nfrac);
char* num2string(long num, int nfrac, int *strlength, char *str17);
void write_lcd_inst(int byte, int wait_usec);
void write_lcd_data(int byte, int wait_usec);
void write_lcd_nibble(int nibble, int wait_usec);
int delta_t(unsigned count_start);
void wait(long wait_usec);
void wait_n_samples(int n);
int prog_flash(unsigned start, unsigned length, unsigned *datawords, int erase_flag, char *error_text);
void read_flash(unsigned start, unsigned length, unsigned *datawords);
void compute_fir(float f1, float f2, int order, int index_ab_tmp);
void load_userfir(int iorder, int index_ab_tmp);
void compute_notch(float fn, float fw, int index_ab_tmp);
void xmit(char *text);
void parse_command(void);
void update_dsp(int param_ptr_tmp, int index_ab_tmp);
void set_all_gains(void);
void gain(int index_ab_tmp);
void vu_update(void);
unsigned convert_to_vu(float scale, int signal);
void led_update(void);
void store(void);
void recall(void);
void beep(unsigned duration, unsigned period);
int record_bad(void);
void store_all(void);
/* fcomplex Cadd(fcomplex a, fcomplex b);
fcomplex Csub(fcomplex a, fcomplex b);
fcomplex Cmul(fcomplex a, fcomplex b);
fcomplex Complex(float re, float im);
fcomplex Conjg(fcomplex z);
fcomplex Cdiv(fcomplex a, fcomplex b);
fcomplex Csqrt(fcomplex z);
fcomplex RCmul(float x, fcomplex a); */


/*========================================================================
 =
 =  main() 
 =
 =========================================================================*/
void main(void) 
{
unsigned count_start;
unsigned ptr;
int itemp;
float ftemp;

/* unsigned long idum;
unsigned int utemp; */

/* boot2(); /* Test the boot2 code */

initialize();   /* initialize DSP hardware */

/* temp = memtest(0x1000,0x7fff,0xabcd);    /* start, stop, value, returns: 0 if OK */


#if(MAIN)

#if(1)     /* fix: make 1 if not */
/* Check validity of FLASH data memory (sector 3), and write defaults if necessary: */
/* Search for end of record data in FLASH */
ptr = 0x6000;   /* point to first record */
read_flash(ptr, 5, record);     /* read part of record header */
itemp = 0;
if(record[0]==0xffff){
  store_all();  /* store current settings to all flash memory locations */
}
while(record[0]!=0xffff){
  /* Check for valid version and SN in each record: */
  if(record_bad()){
    store_all();    /* store current settings to all flash memory locations */
    break;
  }
  ptr = record[0];              /* point to next location */
  read_flash(ptr, 5, record);   /* read part of record header */
}


/* Recall settings from memory location 0: */
params[11][0] = 0;  /* load recall location value */
params_changed_copy = 3;
recall();           /* recall location 0 settings */

#endif  /* #if(1) */

#endif  /* #if(MAIN) */


sign_on();  /* display the sign-on message */


/**************************************************************************/
/***** Start forground loop: **********************************************/
while(1){   /* Loop here and flash cursor until a parmeter change is detected or */
            /* or untill serial data is received: */
  if(cursor_flag&&(!sw_down)){
/*    portfff5 &= ~0x0200;  /* suspend delta interrupts while updating display */
    disp_text("", cursor_pos, -1);  /* turn cursor off */
/*    portfff5 |= 0x0200;   /* re-enable delta interupts */
    if(auto_vu_count){  
      if((auto_vu_count++)>10){
        cursor_pos_vu = cursor_pos; /* save cursor position when auto VU is turned on */                        
/*        portfff5 &= ~0x0200;  /* suspend delta interrupts while updating display */
        disp_text(param_struct[1].text, 1, 0);  /* write "Levels:In  Out  " to display */
        disp_text("", cursor_pos_vu, 0);    /* put cursor back */
/*        portfff5 |= 0x0200;   /* re-enable delta interupts */
        assembly_flag |= 3;     /* turn on VU display (auto VU meter code 3) */
        auto_vu_count = (int)params[2][0];  /* restart counter; set to 0 or 1 depending on RevertToLevels */
      }
    }
  }
  else if(press_flag==0){   /* keep from turning on cursor when press action is pending */
/*    portfff5 &= ~0x0200;  /* suspend delta interrupts while updating display */
    disp_text("", cursor_pos, flash_cursor_flag);   /* turn cursor on, if flash_cursor_flag==1 */
/*    portfff5 |= 0x0200;   /* re-enable delta interupts */
  }
  
  for(itemp=0;itemp<CURSOR_PERIOD;itemp++){     /* loop for multiple of 5ms */
    count_start = portfffa;     /* grab current timer value (for loop interval timing) */
    while(delta_t(count_start)<5000){   /* loop until 5ms time interval is over */

      if(write_ptr!=read_ptr){  /* something in serial_in_buf[] */
        parse_command();        /* check if command complete, parse and execute */
        count_start = portfffa; /* grab current timer value to avoid delta_t() overflow (resets interval) */
      }

      if(serial_error_flag==1){ /* RS-232 comm. error in txrxint_c() */
        serial_error_flag = 0;  /* reset flag */
/*        disp_text("Reduce Baud Rate", 1, -1); */
/*        disp_text("Baud Rate Error!", 1, -1); */
        disp_text("RS-232 Error!   ", 1, -1);
        disp_text("", 1, 0);    /* send cursor home */
        beep(200, 400);
/*        assembly_flag &= ~3;  /* Turn off the VU Meter */
/*        auto_vu_count = (int)params[2][0];    /* restart counter; set to 0 or 1 depending on RevertToLevels */
        reset_port();
      }


#if(MAIN)
      if(params_changed){
        portfff5 &= ~0x0200;    /* suspend delta interupts so params_changed flag is not modifed here: */
        params_changed_copy = params_changed;   /* make working copy for update_dsp() */
        params_changed = 0;     /* reset change flag */
        portfff5 |= 0x0200;     /* re-enable delta interupts */
        update_dsp(param_ptr, index_ab);    /* update the DSP's function to reflect current parameters */
        count_start = portfffa; /* grab current timer value to avoid delta_t() overflow (resets interval) */
      }
#endif
    
    }   /* end while() */

#if(MAIN)
    led_update();           /* set overload LEDs to reflect the status of the overload bits */

    portfff5 &= ~0x0200;    /* suspend delta interupts while testing VU flag and vu levels to display vu_update() */
    if(assembly_flag&3){
      vu_update();          /* update VU meters (this is usually called every 5ms) */
    }
    portfff5 |= 0x0200;     /* re-enable delta interupts */

    rand();         /* Call the rand number generator so muliple modules will tend to get out of step.
                       Used for the random delay for the "sendsn" command. (usually called every 5ms) */
#endif

  } /* end for() */


  /* asm("  idle    ");         /* hold here and save power (untill interrupt returns) */
  /* asm("  rpt     #45 ");     /* test non-interuptable foreground 42 OK */
  asm(" nop         ");


}  /* END loop forever */

} /* end main */
/*========================================================================*/


/**************************************************************************
 *
 *  initialize(): Initialize DSP hardware
 *
 **************************************************************************/

void initialize(void)
{
int i, j, nstart, n_offset, nlength, nfrac, temp;
char ctemp;
unsigned flag_temp, cursor_temp, utemp;
unsigned* uptr;                                                 


asm("   setc    INTM    ; disable all interrupts    ");
asm("   setc    SXM     ; set sign extension bit (sign-extension on)");
asm("   clrc    CNF     ; map internal memory block B0 into Data space");
asm("   clrc    OVM     ; clear overflow mode bit => normal overflow (assumed by c)");
asm("   spm     0       ; set product shift mode to No Shift (assumed by c)");

/* Initialize global variables: */
sw_down=0, sw_pressed=0, sw_released=0; /* used by txrxint_c */
cw=0, ccw=0, testcount=0;
down_turn_flag=0, press_flag=0;
param_ptr=0, write_ptr=0, read_ptr=0, p_state=0, flag_options=0;
serial_error_flag = 0;  /* no RS-232 error */
led_counter=0, vu_counter=0;
in_a_vu_level=0, in_b_vu_level=0, out_a_vu_level=0, out_b_vu_level=0;
quietsn_flag = 0;
iorder_old=0;
flash_locked=1; /* lock programming of FLASH memory when set */
flash_cursor_flag = 1;  /* start with cursor flashing */
params_changed=2;   /* flag parameter has changed */
max_in_level=20;    /* set calibration constant */
min_value=LONG_MIN, max_value=LONG_MAX; /* limit min and max values of current parameter */

init_params();      /* init. params[][] */
set_fsample();      /* Set the CODEC sampling rate (must call after init_params()) */
init_freq_params();


/* Setup pointers to absolute internal data memory locations: */
imr_ptr = (volatile unsigned int *)4;   /* pointer to IMR (Interrupt Mask Register) */
greg_ptr = (volatile unsigned int *)5;  /* pointer to GREG (Global Memory Allocation Reg) */
ifr_ptr = (volatile unsigned int *)6;   /* pointer to IFR (Interrupt Flag Register) */

*imr_ptr = 0;       /* mask all interrupts */
*ifr_ptr = CLR_ALL; /* clear pending interrupts */
*greg_ptr = 0x0080; /* map flash memory to global data space 0x8000 to 0xffff */ 
portffe8 = 1;       /* CLK: turn off CLKOUT1 DSP pin to reduce noise */
portffec = 0x01c;   /* ICR: (Single-edge MODE, mask INT2) */
/* Set wait states (WSGR): I/O, DATA=0, HiProg=0, LowProg=0 (p. 8-15): */
portfffc = (IO_WAITS*0x0200 + 0*0x0040 + 0*0x0008 + 0);

/* Initialize assembly language constants and variables: */
k7f00h = 0x7f00;
kf80fh = 0xf80f;
kfff0h = 0xfff0;
/* MUTE, gainb, gaina: */
out_gain = 0*0x0400 + 0*0x0010 + 0;
/* attenb, attena: */
out_atten = 0*0x0200 + 0*0x0010;
/* VU meter peak hold variables: */
in_a_hold = in_b_hold = out_a_hold = out_b_hold = 0;
assembly_flag = 0;

/* Start the timer free running for wait() and delta_t() usage: */
portfff9 = 0xffff;      /* (PRD) set reload value */
portfff8 = 0x03fc;      /* (TCR) set prescaler for divide by 13 (CLKOUT1/13 = ~1.8904MHz) and reload timer */
portfff8 = 0x03cc;      /* (TCR) start timer */
                        /* TIM counter (portfffa) now counts down from 0xffff and repeats */

func_addr_a = (unsigned)&no_func_a;  /* set function A to none */
func_addr_b = (unsigned)&no_func_b;  /* set function B to none */

coef_ptr_a = 0x0380;    /* point to begining of Ch A IIR coef space */
coef_ptr_b = 0x0300;    /* point to benining of Ch B IIR coef space */

/* orderm2_a = FIR_LENGTH - 2;  /* FIR filter A order minus 2 */
/* orderm2_b = FIR_LENGTH - 2;  /* FIR filter B order minus 2 */


/* Load the Module's serial number (with check sums and terminating null) from code memory: */
get_serial(&serial_str);
/* carray[0] = 0;   /* put null at begining of temp array */
/* strncat(carray, serial_str, 6);  /* get first 6 characters of serial number string */
/* serial_number = atol(carray);    /* convert to long. Don't use atol, it's a long func. */
serial_number = 0;
for(i=0;i<6;i++){
  serial_number = 10*serial_number + (serial_str[i]&0x0f);
}

/* Initialize Liquid Crystal Display and sign on msg. */
port0_copy = 0x0080;    /* Initialize port0 (IO4-11) */
port0 = port0_copy;
reset_lcd();

/* Enable async. port (ASPCR), enable receive and delta interrupts,
   set auto baud-rate detect bit and make IO3 an output: */
reset_port();

/* Crystal CS4218 CODEC setup section: */
*ifr_ptr = CLR_ALL; /* clear pending interrupts again */
portfff1 = 0x4300;  /* SSPCR: Put port into reset, int. when FIFO has 4 words */
portfff1 = 0x4330;  /* SSPCR: Take out of reset */
*imr_ptr = EN_RINT|EN_TXRXINT;  /* Unmask Receive interrupt, Unmask SSP  int. */

auto_vu_count = (int)params[2][0];  /* restart counter; set to 0 or 1 depending on RevertToLevels */
index_ab = params[6][0] ? 0:2;  /* if Mode:A&B Common (params[6][0]==0) then index common params, else index A params */   


#if(MAIN)
/* Read the Module's parameter structure and write the housekeeping data: */
for(i=0;i<NPARAMSTRUCT;i++){
/* Search for first '#' or end-of-string and set nstart, n_offset, nlength and nfrac: */
  nstart = 15;
  nfrac = 0;
  n_offset = 0;
  for(j=0;j<=16;j++){
    ctemp = *(param_struct[i].text + j);
    if(nstart==15){
      if((ctemp=='#')||(ctemp=='_')){
        nstart = j;
        param_struct[i].flag &= 0x7fff; /* clear the text type bit */
      }
      else if(ctemp=='\0'){     /* '#' or '_' not found => "text text" type */
        nstart = j;
        param_struct[i].flag |= 0x8000; /* set the text type bit */
        break;
      }
    }
    else{   /* nstart!=15 */
      if(ctemp=='_'){
        n_offset = j;
      }  
      if(ctemp=='.'){
        nfrac = j;
      }
      else if(!((ctemp=='#')||(ctemp=='_')||(ctemp=='.'))){
        nlength = j - nstart;
        break;
      }
    }
  }
  if(n_offset){
    n_offset -= nstart;
  }
  if(nfrac){
    nfrac = nstart + nlength - nfrac - 1;   /* adjust nfrac to the number of fraction digits */
  }
  if(0x8000&param_struct[i].flag){  /* "text text" type */
    j = -1;
    while(*(char*)(*(char*)(param_struct[i].label + (++j)))!='\0'){} /* count number entries in label pointer */
    param_struct[i].flag = (0xc000&param_struct[i].flag)|(nstart<<10)|j; /* load .flag with --ss ss-- nnnn nnnn */
  }
  else{                             /* "text int" or "text float" type */
    param_struct[i].flag = (0xc000&param_struct[i].flag)|(nstart<<10)|(n_offset<<7)|(nlength<<3)|nfrac; /* load .flag with --ss ssoo olll lfff */
  }
}   /* end for(i=0;i<NPARAMSTRUCT;i++) */


/* Initialize calibration constants with ideal values. Table used, not pow() */
/*for(i=0;i<16;i++){
  in_cal_levels_a[i] = 0.815*pow(10.0, LOG2D4*i)/8.0;
  in_cal_levels_b[i] = 0.815*pow(10.0, LOG2D4*i)/8.0;
}
for(i=0;i<32;i++){
  out_cal_a[i] = 1.69*7.1*pow(10.0, -LOG2D4*i);
  out_cal_b[i] = 1.69*7.1*pow(10.0, -LOG2D4*i);
}  */

set_all_gains();    /* set optimal CODEC gains and attenuations */
#endif

asm("   clrc    INTM        ; Enable interrupts");
wait_n_samples(10); /* wait for ~10 sampling intervals (after turning on ints.) for in_error to update */
in_error_stick = 0; /* reset the sticky bits */
gray_code = 0x0003&portfff6;    /* put rotary encoder bits into gray_code so first sw action is taken */

srand(in_a + serial_number%32768);  /* seed the random number generator with an input sample value plus
                                       the modules serial # mod 2^15. Srand used for the "sendsn" command */

update_disp_left();     /* update display to reflect parameter settings */
update_disp_right(1);

} /* end initialize() */


/**************************************************************************
 * init_params
 * This function initializes the parameters in params[][].
 * Frequency related parameters are set to zero.
 *
 **************************************************************************/
void init_params(void)
{
int j;
unsigned* uptr;

/* load all of params[][] with zeros: */
uptr = (unsigned*)(&params[0][0]);
for(j=0;j<NPARAMSM6;j++){
  *uptr++ = 0;
}

params[0][0] = params[0][1] = params[0][2] = 1; /* Default FUNC: AllPass */
params[3][0] = 20;  /* FullScalIn:20Vpp */
params[4][0] = 1;   /* SampleRate:48KHz */

params[15][0] = params[18][0] = params[21][0] = params[27][0] = params[33][0] = params[36][0] = params[39][0] = params[42][0] = params[45][0] =
params[15][1] = params[18][1] = params[21][1] = params[27][1] = params[33][1] = params[36][1] = params[39][1] = params[42][1] = params[45][1] =
params[15][2] = params[18][2] = params[21][2] = params[27][2] = params[33][2] = params[36][2] = params[39][2] = params[42][2] = params[45][2] = 100; /* gains */

params[17][0] = params[20][0] = params[26][0] = params[32][0] = params[40][0] = 
params[17][1] = params[20][1] = params[26][1] = params[32][1] = params[40][1] = 
params[17][2] = params[20][2] = params[26][2] = params[32][2] = params[40][2] = 127; /* filtorder: 127 */

params[41][0] = params[41][1] = params[41][2] = 1;  /* first coef. pointer */
}


/**************************************************************************
 * init_freq_params
 * This function initializes the frequency related parameters in params[][].
 *
 **************************************************************************/
void init_freq_params(void)
{

params[16][0] = params[19][0] = params[22][0] = params[25][0] = params[28][0] = params[31][0] =
params[16][1] = params[19][1] = params[22][1] = params[25][1] = params[28][1] = params[31][1] =
params[16][2] = params[19][2] = params[22][2] = params[25][2] = params[28][2] = params[31][2] = 

params[34][0] = params[37][0] =
params[34][1] = params[37][1] =
params[34][2] = params[37][2] = 1000; /* fcut, f1, fwdth, fnotch */

params[23][0] = params[29][0] =
params[23][1] = params[29][1] =
params[23][2] = params[29][2] = 2000;   /* f2 */

params[24][0] = params[30][0] =
params[24][1] = params[30][1] =
params[24][2] = params[30][2] = 1500;   /* fcntr */

params[35][0] = params[38][0] =
params[35][1] = params[38][1] =
params[35][2] = params[38][2] = 1000; /* Notch width and Inv.notch width */

params[43][0] =
params[43][1] =
params[43][2] = 10000;  /* Sine freq (1000Hz) */

}


/**************************************************************************
 * set_fsample
 * This function sets fsample and the state of the XF pin.
 *
 **************************************************************************/
void set_fsample(void)
{
long ltemp;

/* out_gain |= 0x0400;      /* mute the outputs (still pops) */
if(params[4][0]){   /* if (desired sample rate = 48KHz) */
  asm("     clrc    XF      ; Set the CODEC sampling rate to 48 Ksps");
  fsample = 48000.0;        /* set new sampling rate */
}   
else{
  asm("     setc    XF      ; Set the CODEC sampling rate to 8 Ksps");
  fsample = 8000.0;         /* set new sampling rate */
}


/* wait_n_samples(200); /* wait for ~200 sampling intervals for CODEC to recalibrate */
/* out_gain &= ~0x0400; /* un-mute the outputs */
}


/**************************************************************************
 * reset_port
 * This function resets the async. port (ASPCR), enables receive and
 * delta interrupts, sets auto baud-rate detect bit and makes IO3 an output.
 *
 **************************************************************************/
void reset_port(void)
{
portfff5 = 0;       /* make shure port is reset */
portfff6 = 0x66f0;  /* IOSR: reset all bits */
portfff5 = ASPCR_URST;
portfff5 = 0;
#if(MAIN)
portfff5 = (ASPCR_URST|ASPCR_DIM|ASPCR_RIM|ASPCR_CAD|ASPCR_CIO3);
#else
portfff5 = (ASPCR_URST|          ASPCR_RIM|ASPCR_CAD|ASPCR_CIO3);
#endif
portfff6 = 0x66f0;  /* IOSR: reset all bits */
}


/**************************************************************************
 * sign_on
 * This function displays the sign on message.
 *
 **************************************************************************/
void sign_on(void)
{
#if(MAIN)

#if(SIGN_ON_FLAG_Versa_Filter)
disp_text("Versa-Filter2-20", 1, -1);
wait(1000000);  /* wait 1 sec. */
#endif

#if(SIGN_ON_FLAG_AccuQuest)
disp_text("   AccuQuest    ", 1, -1);
wait(1500000);  /* wait 1.5 sec. */

disp_text("  AQC5501-001   ", 1, -1);
wait(1500000);  /* wait 1.5 sec. */
#endif

disp_text("Testing         ", 1, 0);
wait(100000);   /* wait .1 sec. */
disp_text(".", 9, 0);
wait(100000);   /* wait .1 sec. */
disp_text(".", 11, 0);
wait(100000);   /* wait .1 sec. */
disp_text(".", 13, 0);
wait(100000);   /* wait .1 sec. */
disp_text("OK", 15, 0);
wait(400000);   /* wait .4 sec. */

update_disp_left();     /* display parameter state (done in recall() below) */
update_disp_right(1);


#else   /* if not MAIN */
disp_text("Programming Mode", 1, -1);
wait(1000000);  /* wait 1 sec. */

disp_text("Firmware:  V", 1, 0);
disp_num(VERSION, 13, 4, 2);
wait(1000000);  /* wait 1 sec. */

disp_text("Serial No:", 1, 0);
disp_num(serial_number, 11, 6 ,0);
wait(1000000);  /* wait 1 sec. */ 

disp_text("Ready to program", 1, 0);
disp_text("", 16, 1);   /* turn on cusor in position 16 */

#endif
}


/**************************************************************************
 * parse_command
 * This function reads the serial_in_buf[] from the last read entry to the
 * write_ptr. The characters in the buffer are used to update the command
 * parser state and read the incomming command strings. When a valid command
 * is parsed it is executed.
 *
 **************************************************************************/
void parse_command(void)
{
int i, j, itemp, iflag, cursortemp, execute_flag=0, program_flag=0, prog_err_flag=0;
int param_ptr_temp, index_ab_temp, flag_options_temp, change_value_flag;
long param_value;
char *value_ptr, *cptr;
char ctemp, craw;
char carray[17];
unsigned utemp;

/*portfff5 &= ~0x0200;  /* suspend delta interupts while updating display (disp_xxxx below) */
cursortemp = cursor_pos;    /* save current cursor position */

while(write_ptr!=read_ptr){
  craw = serial_in_buf[read_ptr++]; /* get current character */
  ctemp = tolower(craw);            /* convert to lower case */
  read_ptr &= SERIAL_BUF_LEN-1; /* make shure that read_ptr was incremented modulo SERIAL_BUF_LEN */
/* disp_text("                ", 1, -1); */
/* disp_text(&ctemp, 1, -1); */
#if(1)  /* fix: set to 1 if not */
  switch(p_state){
  case 0:   /* Start of parse: */
    if(ctemp=='a') p_state = 1;
    sn_ok_flag = 0;
    break;
  case 1:   /* Received: a */
    if(ctemp=='t') p_state = 2;
    else if(ctemp=='a') p_state = 1;
    else p_state = 0;
    break;
  case 2:   /* Received: at */
    if(ctemp=='a') p_state = 3;
    else if(ctemp=='s') p_state = 5;
    else if(ctemp==' ') p_state = 2;
    else p_state = 0;
    break;
  case 3:   /* Received: at a */
    if(ctemp=='t') p_state = 2;
    else if(ctemp=='l') p_state = 4;
    else p_state = 0;
    break;
  case 4:   /* Received: at al */
    if(ctemp=='l'){
        sn_ok_flag = 1;
        p_state = 20;
      }
    else p_state = 0;
    break;
  case 5:   /* Received: at s */
    if(ctemp=='n') p_state = 6;
    else p_state = 0;
    break;
  case 6:   /* Received: at sn */
    if(ctemp==':') p_state = 7;
    else p_state = 0;
    break;
  case 7:   /* Received: at sn: */
    if(isdigit(ctemp)){
      p_state = 8;
      p_long = (long)(ctemp&0x0f);  /* convert character to number */
    }
    else if(ctemp==' ') p_state = 7;
    else p_state = 0;
    break;
  case 8:   /* Received: at sn:# */
    if(isdigit(ctemp)){
      p_long = 10*p_long + (long)(ctemp&0x0f);  /* convert character to number; next digit */
      p_state = 8;
    }
    else if(ctemp==' ') p_state = 8;
    else if(ctemp==','){
      if(p_long==serial_number){
        sn_ok_flag = 1;
        p_state = 20;
      }
      else{
        p_long = 0;
        p_state = 8;
      }
    }
    else{
      /* Modulo decrement read_ptr because current char could be the first char of command: */
      if((read_ptr--)==0){
        read_ptr = SERIAL_BUF_LEN-1;
      }
      if(p_long==serial_number){
        sn_ok_flag = 1;
      }
      else{
        sn_ok_flag = 0;
      }
      p_state = 20;
    }
    break;

  case 20:  /* Received valid header and serial number (eg. at sn:132001) */
    if(isalpha(ctemp)){ /* if ctemp is a letter */
      for(i=0;i<17;i++){
        parameter_str[i] = value_str[i] = '\0'; /* clear command strings */
      }
      parameter_str[0] = ctemp; /* load first char of parameter */
      p_state = 21;
    }
    else if(ctemp=='\r') p_state = 0;   /* carrage return */
    else p_state = 20;
    break;
  case 21:  /* Received first letter of parameter, now get rest... */
    if(ctemp=='\r'){    /* carrage return */
      execute_flag = 1;
      p_state = 0;
    }
    else if(ctemp==':'){    /* if parameter reception complete */
      p_state = 22;
      if(strncmp(parameter_str, "program",7)==0){;  /* if parameter_str == "program" */
        func_addr_a = (unsigned)&no_func_a;  /* set the functions to none to get maximum CPU time */
        func_addr_b = (unsigned)&no_func_b;  /* set the functions to none to get maximum CPU time */
        assembly_flag &= ~3;    /* turn off the VU Meter */
        /* auto_vu_count = (int)params[2][0];   /* restart counter; set to 0 or 1 depending on RevertToLevels */
        p_state = 40;
      }
    }
    else{
      i =  strlen(parameter_str);
      if(i<16){
        parameter_str[i] = ctemp;   /* load next available location with char */
      }
      else{
        p_state = 0;
      }    
    }
    break;
  case 22:  /* Received all of parameter (eg. at sn:132001 param:),
               now get value with UPPER or lower cases...              */
    if(ctemp=='\r'){    /* carrage return */
      execute_flag = 1;
      p_state = 0;
    }
    else if(ctemp==':'){    /* second ':', final params are comming (must be the 'func:UserFIR: # # ...') */
      func_addr_temp_a = func_addr_a;   /* save the current A function */
      func_addr_temp_b = func_addr_b;   /* save the current B function */
      func_addr_a = (unsigned)&no_func_a;   /* set the functions to none to get maximum CPU time */
      func_addr_b = (unsigned)&no_func_b;
      data_count = 0;   /* clear coef. order counter */
      p_state = 30;
    }
    else{
      i =  strlen(value_str);
      if(i<16){
        value_str[i] = craw;    /* load next available location with U/l char */
      }
      else{
        p_state = 0;
      }
    }
    break;

  /* Read user FIR parameters: */
  case 30:  /* Received 'param:value:' (likely: 'func:UserFIR:'), now get numbers */
    p_state = 31;
    if(ctemp==' ') p_state = 30;
    else if(ctemp=='-'){
      sign_mult = -1;
      p_long = 0;
    }
    else if(isdigit(ctemp)){
      sign_mult = +1;
      p_long = (long)(ctemp&0x0f);  /* convert character to number */
    }
    else if(ctemp=='\r') goto p_cont1;
    else p_state = 0;
    switch(parameter_str[0]){   /* look at first letter of parameter_str[] */
    case 'a':   /* 'afunc' likely */
      index_ab_p = 0;
      break;
    case 'b':   /* 'bfunc' likely */
      index_ab_p = 1;
      break;
    case 'f':   /* 'func' likely */
      index_ab_p = 2;
      break;
    default:
      p_state = 0;
      break;
    }   /* end switch(parameter_str[0]) */
    break;
  case 31:  /* Received 'func:UserFIR: # -' or 'func:UserFIR: # #' */
    if(isdigit(ctemp)){
      p_long = 10*p_long + (long)(ctemp&0x0f);  /* convert character to number; next digit */
    }
    else if((ctemp==' ')||(ctemp=='\r')){   /* coef. ready */
      p_state = 30;
      p_long = sign_mult*p_long;        /* change sign if nessasary */
      if(p_long>32767){                 /* hard limit values */
        p_long = 32767;
      }
      if(p_long<-32768){
        p_long = -32768;
      }
      utemp = NPARAMSTRUCT + (data_count>>1);   /* offset plus data_count divided by 2 */
      if((data_count++)&0x0001){        /* if data count odd: 1, 3, 5,... */
        params[utemp][index_ab_p] |= (p_long<<16);  /* load odd coef. into MS Byte of array */
      }
      else{ /* data count even: 0, 2, 4,... */
        params[utemp][index_ab_p] = p_long&0x0000ffff;      /* load even data into array */
      }
      if(params[6][0]==2){  /* if Ch A Only */
        itemp = 256;        /* allow long filters on Ch A */
      }
      else{
        itemp = 128;  
      }
      if(data_count>itemp){
        data_count = itemp;
        goto p_cont1;   /* got maximum number of filter taps */
      }
    }
    else p_state = 0;
    if(ctemp=='\r'){    /* if ctemp carrage return, then we are done getting FIR coefs */
p_cont1:
      if(data_count<3) data_count = 3;      /* 3 is the minimum filter order */
      params[40][index_ab_p] = data_count;  /* save order of the filter that was just loaded */
      params[41][index_ab_p] = 1L;  /* set coef. pointer to 1 when changing order */
      func_addr_a = func_addr_temp_a; /* reset the function */
      func_addr_b = func_addr_temp_b; /* reset the function */
      execute_flag = 1;
      p_state = 0;
    }
    break;

  /* Read FLASH programming parameters: */
  case 40:  /* Received "program:" string */
    if(ctemp==' ') p_state = 40;
    else if(ctemp=='s') p_state = 41;
    else p_state = 0;
    break;
  case 41:  /* Received "program: s". */
    if(ctemp==' ') p_state = 41;
    else if(ctemp==':') p_state = 42;
    else p_state = 0;
    break;
  case 42:  /* Received "program: s:" */
    if(isdigit(ctemp)){
      p_uint1 = (unsigned)(ctemp&0x0f); /* convert character to number */
      p_state = 43;
    }
    else if(ctemp==' ') p_state = 42;
    else p_state = 0;
    break;
  case 43:  /* Received "program: s:#" */
    if(isdigit(ctemp)){
      p_uint1 = 10*p_uint1 + (unsigned)(ctemp&0x0f);    /* convert character to number; next digit */
      p_state = 43;
    }
    else if(ctemp==' ') p_state = 43;
    else if(ctemp=='l') p_state = 44;
    else p_state = 0;
    break;
  case 44:  /* Received "program: s:# l". */
    if(ctemp==' ') p_state = 44;
    else if(ctemp==':') p_state = 45;
    else p_state = 0;
    break;
  case 45:  /* Received "program: s:# l:" */
    if(isdigit(ctemp)){
      p_uint2 = (unsigned)(ctemp&0x0f); /* convert character to number */
      p_state = 46;
    }
    else if(ctemp==' ') p_state = 45;
    else p_state = 0;
    break;
  case 46:  /* Received "program: s:# l:#" */
    if(isdigit(ctemp)){
      p_uint2 = 10*p_uint2 + (unsigned)(ctemp&0x0f);    /* convert character to number; next digit */
      p_state = 46;
    }
    else if(ctemp==' ') p_state = 46;
    else if(ctemp=='d') p_state = 47;
    else p_state = 0;
    break;
  case 47:  /* Received "program: s:# l:# d". */
    if(ctemp==' ') p_state = 47;
    else if(ctemp==':'){
      /* Check start and stop parameters */
      /* (must start at beginning of a sector and be one sector long max.) */
      if(((p_uint1==0x0000)||(p_uint1==0x2000)||(p_uint1==0x4000)||(p_uint1==0x6000)||
      (p_uint1==0x8000)||(p_uint1==0xa000)||(p_uint1==0xc000)||(p_uint1==0xe000))&&(p_uint2<=0x2000)&&
      (p_uint2>0)){
        if(sn_ok_flag){     /* fix: don't need because we will not get this far with invalid SN */
          disp_text("Recvd    0 Words", 1, -1);
        }
        data_count = 0;
        check_sum = 0;
        p_state = 48;
      }
      else{
        prog_err_flag = 1;
        p_state = 0;
      }
    }
    else p_state = 0;
    break;
  case 48:  /* Programming parameters valid, now load flash_data array..." */
    if(data_count<(p_uint2<<1)){
      utemp = data_count>>1;    /* divide data_count by 2 */
      if(data_count&0x0001){    /* if byte count odd: 1, 3, 5,... */
        flash_data[utemp] = flash_data[utemp] | craw;   /* load odd data into array */
        if(sn_ok_flag){     /* fix: don't need because we will not get this far with invalid SN */
          if(((utemp+1)&0x002f) == 0){
            disp_num((long)(utemp) + 1, 6, 5 ,0);   /* periodicaly update "Recvd     Words" */
          }
        }
      }
      else{ /* byte count even: 0, 2, 4,... */
        flash_data[utemp] = (craw<<8);  /* load even data into MS Byte of array */
      }
      check_sum += craw;                /* compute running sum */
      data_count++;
    }
    if(data_count==(p_uint2<<1)){
      if(sn_ok_flag){
        disp_num((long)((data_count-1)>>1) + 1, 6, 5 ,0);   /* update final "Recvd     Words" */
        wait(1000000);  /* wait 1 sec. */
      }
      data_count = 0;
      p_sum = 0;
      p_state = 49;
    }
    break;
  case 49:  /* Received FLASH data, now get transmitted check sum, and verify... */
    if(data_count<8){   /* receiving check sum */
      if(isdigit(ctemp)){
        p_sum = 10*p_sum + (long)(ctemp&0x0f);  /* convert character to number; next digit */
      }
      else if(ctemp==' ') p_state = 49;
      else{
        prog_err_flag = 1;
        p_state = 0;    /* space or digit expected */
      }
    }
    if((data_count++) == 7){    /* full check sum received, verify: */
      if(p_sum==check_sum){ /* received check sum == calculated check sum */
        program_flag = 1;   /* set flag to program FLASH */
      }
      else{ /* bad check sum */
        prog_err_flag = 1;
      }
      p_state = 0;
    }
    break;

  default:
    break;
  } /* end switch(p_state) */


/* Execute serial Command section: */

/*disp_text("                ", 1, -1); /* for testing only */
/*disp_text(parameter_str, 1, -1);
disp_text(value_str, 9, -1); */

#if(MAIN)

  if(sn_ok_flag && execute_flag){     /* Execute command in parameter_str and value_str (if valid) */
    if(strncmp(parameter_str, "reset", 5)==0){
      initialize(); /* initialize DSP hardware */
      /* sign_on(); /* display the sign-on message */
    }
    else if(strncmp(parameter_str, "display", 7)==0){
      if(value_str[0]!='\0'){   /* if value_str not empty display contents */
        disp_text("                ", 1, -1);
        disp_text(value_str, 1, -1);
        flash_cursor_flag = 0;  /* stop flashing currsor */
/*assembly_flag &= ~3;  /* turn off the VU Meter */
/*auto_vu_count = (int)params[2][0];    /* restart counter; set to 0 or 1 depending on RevertToLevels */
      }
      else{                     /* else go back to normal display */
        update_disp_left();     /* update display to reflect parameter settings */
        update_disp_right(1);
        params_changed = 1;     /* set change flag to update assembly_flag to turn on VU meters if nessasary */
        flash_cursor_flag = 1;  /* resume flashing currsor */
      }
    }
    else if(!quietsn_flag && strncmp(parameter_str, "sendsn", 6)==0){
      portfff5 &= ~0x0080;  /* suspend async. receive ints. so this module
                             will not hear itself or other modules talking.
                             This avoids serial receive buffer overflows. */
      wait(SENDSN_WAIT*(long)rand());   /* wait a random ammout of time, rand() is 0 to 32767 */
      xmit(serial_str);     /* send serial number with check sums out the RS-232 port */
    }
    else if(strncmp(parameter_str, "quietsn", 7)==0){
      quietsn_flag = 1;     /* don't send serial number on sucsesive "sendsn" commands */
    }
    else if(strncmp(parameter_str, "echo", 4)==0){
      disp_text("                ", 1, -1);
      disp_text(value_str, 1, -1);
      flash_cursor_flag = 0;    /* stop flashing currsor */
      xmit(value_str);          /* send value_str out the RS-232 port */
    }

    else{   /* standard serial command sent */
      /* Do parameter search here: */
      param_ptr_temp = param_struct_search(&itemp); /* search param_struct[i].text for parameter_str[] */
      if(!itemp){   /* if no match */
        goto parse_continue;    /* error in parameter_str[] */
      }
      flag_options_temp = 0;
      if(itemp==3){         /* if 1-offset: " APgain"=="APgain" */
        index_ab_temp = 2;  /* common section parameter found */
      }
      else if(itemp==1){    /* if 0-offset: "Store"=="Store" */
        index_ab_temp = 0;  /* options section parameter found */
        flag_options_temp = 1;
      }
      else if(itemp==2){    /* if 0-offset after first: " APgain"=="bAPgain" */
        if(parameter_str[0]=='a'){
          index_ab_temp = 0;
        }
        else if(parameter_str[0]=='b'){
          index_ab_temp = 1;
        }
        else{
          goto parse_continue;  /* error in parameter_str[] */
        }
      }
      
      /* Test if param_ptr_temp, index_ab_temp, and flag_options_temp are valid for
         the current module func and mode settings: */
      if(!flag_options_temp){   /* if received command is not in options section, do more tests: */
        itemp = (int)params[0][index_ab_temp];  /* get function code for received memory area */
        /* If received command does not correspond to current function, then error: */
        if(   (params[6][0]==0 && index_ab_temp!=2)     /* if Mode==A&B Common and no common param */
           || (params[6][0]!=0 && index_ab_temp==2) ){  /* if Mode!=A&B Common and common param */
           goto parse_continue; /* error in parameter_str[] */
        }     
        /* if received command not related to current function */
        if(param_ptr_temp&&(param_ptr_temp<param_ptr_start[itemp] || param_ptr_temp>param_ptr_end[itemp])){
           goto parse_continue; /* error in parameter_str[] */
        }     
      }
      /* A valid match to parameter was found. Now now get value: */
      value_ptr = &value_str[0];    /* point to value string */                                                   
      while(*value_ptr==' ') value_ptr++;   /* skip leading spaces value_str[] */
      param_value = 0;
      change_value_flag = (*value_ptr!='\0');   /* if value_str is not a null, change param value below */
      utemp = param_struct[param_ptr_temp].flag;    /* get the flag bits */  
      if(utemp>>15){    /* display type: "text text" */
        itemp = utemp&0xff; /* get nnnn nnnn */
/*        if(itemp==0) change_value_flag = 1;   /* if null_text label case, always set change flag */
/*   if(itemp==0) params_changed = 1;   /* if null_text label case, always update display */
        /* Search over the nnnn nnnn text label entries of the parameter match: */
        for(i=0;i<itemp;i++){   /* loop is skipped in null_text label case */
          param_value = -1;
          cptr = (char*)(*(char*)(param_struct[param_ptr_temp].label + i)); /* get pointer to beginning of ith parameter text */
          while(*cptr==' ') cptr++; /* skip leading spaces of label */
          if(string_compare(cptr, value_ptr)){  /* if match (a null matches anything) */
            param_value = (long)i;  /* return the param_value that points to the matching text */
            break;
          }
        }
        if(param_value<0){  /* if no match */
          goto parse_continue;  /* error in parameter_str[] */
        }
      }
      else{     /* display type: "text int" or "text float" */
        /* Convert value_str[] to a number: */
        if(iflag = (*value_ptr=='-')) value_ptr++;  /* if first char. '-', set minus sign flag  */
                                                    /* and skip character */
        itemp = (int)(0x0007&utemp); /* get fff, number of fractional digits */
        i = 0;
        do{     /* extract the number scaled by the number of fractional digits */
          ctemp = *value_ptr++; /* get character */
          j = isdigit(ctemp);
          if(i==0 && !j){   /* the first non-number (usualy a ".") starts the read counter */
            i = 1;
          }
          else{
            if(j){
              param_value = 10*param_value + (long)(ctemp&0x0f);
            }
            else{
              param_value = 10*param_value;
            }
            if(i) i++;
          }
        } while(i<=itemp);
        
        if(iflag){                      /* if negative flag */
          param_value = -param_value;   /* negate */
        }

        /* Check limits on numerical parameter value: */
        params_changed_copy = 1;            /* flag to update_dsp() to */
        update_dsp(param_ptr_temp, index_ab);   /* update min_value and max_value only */
        if(param_value>max_value){          /* hard limit values */
          param_value = max_value;
        }
        if(param_value<min_value){
          param_value = min_value;
        }
      }
      
      flag_options = flag_options_temp; /* load flag_options with return value of search */
      param_ptr = param_ptr_temp;       /* load param_ptr */
      index_ab = index_ab_temp;         /* load index_ab */

      
      if(change_value_flag){    /* update params[][] with param_value */
        params[param_ptr][index_ab] = param_value;  /* load new parameter value */
        params_changed = 3;     /* flag main loop to update DSP (because we changed parameter values) */
      }
      else{ /* no value was specified, so x-mit current value out the RS-232 port */
        param_value = params[param_ptr][index_ab];  /* get current param value */
        if(utemp>>15){  /* display type: "text text" */
          if(param_ptr_temp==1){        /* If "Levels" parameter, write current hold values: */
            /* xmit(num2string((long)(scale_k_a*(float)in_a_hold), 0, &i, (char*)&carray));
            xmit(num2string((long)(scale_k_b*(float)in_b_hold), 0, &i, (char*)&carray));
            xmit(num2string((long)(scale_k_a*(float)out_a_hold), 0, &i, (char*)&carray));
            xmit(num2string((long)(scale_k_b*(float)out_b_hold), 0, &i, (char*)&carray)); */
          }
          else if(param_ptr_temp==12){  /* If "Firmware" parameter, write version: */
            xmit(num2string(VERSION, 2, &i, (char*)&carray));
          }
          else if(param_ptr_temp==13){  /* If "Serial No" parameter, write SN: */
            xmit(num2string(serial_number, 0, &i, (char*)&carray));
          }
          else{     /* some other "text text" parameter */
            /* transmit current parameter text out the RS-232 port: */
            xmit((char*)(*(char*)(param_struct[param_ptr_temp].label + param_value)));
          }
        }
        else{       /* display type: "text int" or "text float" */
          itemp = (int)(0x0007&utemp); /* get fff, number of fractional digits */
          /* transmit current parameter value out the RS-232 port: */
          xmit(num2string(param_value, itemp, &i, (char*)&carray));
        }
        params_changed = 1;     /* flag main loop to update only min. and max. */
      }
      update_disp_left();           /* update display to reflect parameter settings */
      update_disp_right(1);
      flash_cursor_flag = 1;    /* resume flashing currsor */
/*assembly_flag &= ~3;  /* turn off the VU Meter */
/*auto_vu_count = (int)params[2][0];    /* restart counter; set to 0 or 1 depending on RevertToLevels */
    }   /* end parameter search */
    
    
parse_continue:
    execute_flag = 0;
  }
#endif  /* #if(MAIN) */


  if(sn_ok_flag && prog_err_flag){
    disp_text("PARAMETER ERROR ", 1, -1);
    wait(1000000);  /* wait 1 sec. */
    disp_text("WRITE ABORTED!  ", 1, -1);
    wait(2000000);  /* wait 2 sec. */
    update_disp_left();     /* update display to reflect parameter settings */
    update_disp_right(1);
    params_changed = 2;     /* flag main loop to update DSP (because we changed func_addr_a and _b above) */
    prog_err_flag = 0;
/*assembly_flag &= ~3;  /* turn off the VU Meter */
/*auto_vu_count = (int)params[2][0];    /* restart counter; set to 0 or 1 depending on RevertToLevels */
  }

  if(sn_ok_flag && program_flag){     /* Program FLASH */
/*auto_vu_count = (int)params[2][0];    /* restart counter; set to 0 or 1 depending on RevertToLevels */
/*    disp_text("                ", 1, -1);
    disp_text("start=",-1);
    disp_num(p_uint1,7,2,0);
    disp_text("len=", 10, -1);
    disp_num(p_uint2,14,2,0); */
    
    /* Check for valid serial number in flash_data: */
    if((p_uint1==0)||(p_uint1==32768)){ /* if programming sector 0 or 4 */
      j = 0;
      itemp = 0;
      for(i=SERIAL_LOC+2;i<SERIAL_LOC+7;i++){
        utemp = flash_data[i];
        carray[j++] = (char)((utemp&0xff00)>>8);    /* get upper byte from flash_data[] */
        carray[j++] = (char)(utemp&0x00ff);         /* get lower byte from flash_data[] */
        itemp += (utemp!=0x3030);                   /* scan for ASCII "00" in flash_data[] */
      }                                             /* itemp==0 if serial number was all zeros */
      
      if((itemp==0)||(!valid_serial(carray))){  /* if invalid serial number, substitute current: */
        j = 0;
        for(i=SERIAL_LOC+2;i<SERIAL_LOC+7;i++){
          itemp = (int)serial_str[j++]<<8;              /* get even serial number char */
          flash_data[i] = itemp|((int)serial_str[j++]); /* append odd serial number char */
        }
      }
    }
    
/*assembly_flag &= ~3;  /* turn off the VU Meter */
/*auto_vu_count = (int)params[2][0];    /* restart counter; set to 0 or 1 depending on RevertToLevels */

    disp_text("Programming...  ", 1, -1);
    flash_locked = 0;   /* unlock flash */
    itemp = prog_flash(p_uint1, p_uint2, flash_data, 1, "inUpdate");
    if(itemp==0){   /* if no error */
      disp_text("Sector   Prog OK", 1, -1);
      disp_num(p_uint1/8192, 7, 2 ,0);  /* update final Sector # */
/*    disp_text("Cycle power!    ", 1, -1); /* fix: send this message from PC after all sectors programmed */
/*    wait(1000000);    /* wait 1 sec. */

/*    update_disp_left();       /* update display to reflect parameter settings */
/*    update_disp_right(1);
    params_changed = 2;     /* flag main loop to update DSP (because we changed func_addr_a and _b above) */
      program_flag = 0;
    }
  }
#endif
}   /* end while(write_ptr!=read_ptr) */

/*disp_text("", cursortemp, 0); /* put cursor back */

if(cursor_pos!=cursortemp){     /* if cursor position was modified (by any disp_ above) put into pos. 1 */
  disp_text("", 1, 0);          /* put cursor in position 1 */
}

/*portfff5 |= 0x0200;   /* re-enable delta interupts */

}


/**************************************************************************
 * txrxint_c (delta interrupt service routine)
 * This is the c-code part of the interrupt service routine that handles
 * the user input actions on both the RS-232 and switch inputs.
 * 
 * This interrupt is initially handled in assembly so that the
 * sample interrupts can be quickly turned back on so no
 * samples will be missed.
 *
 **************************************************************************/
void txrxint_c(void)
{
int i, j, temp_pos, type, nstart, n_offset, nlength, nfrac, nlabel;
int io;
int sum2, io0_sum, io1_sum, io2_sum;
unsigned count_start;
long jj;
char carray[8];

/***** Get RS-232 Action: *************************************************/
if(iosr_copy&0x4000){   /* an "a" Detect Complete interrupt occurred */
  portfff5 &= ~ASPCR_CAD;   /* reset the "calibrate "a" detect" (CAD) bit in the ASPCR*/
  portfff6 = 0x4000;    /* reset the ""a" detect complete" (ADC) bit in the IOSR */
}

/* if(portfff6&0x2600){ /* a break, framing error, or receive overrun detected */
/*  disp_text("OVERRUN ERROR!  ", 1, -1);
  wait(1000000);
  disp_num(portfff6,0,16,0);
  wait(1000000);
}   /* for testing */

if(iosr_copy&0x0100){   /* a serial Data Ready interrupt occurred */
  assembly_flag &= ~3;  /* Turn off the VU Meter to help avoid loosing data
                           If the sample int. is bussy (full order filters, VU-meter, wtnoise on)
                           then serial data will be missed if a new character is received too soon.
                           38.4Kbaud seems to be the maximum in this case.                     */

  serial_in_buf[write_ptr++] = portfff4;    /* read the serial data ADTR (also resets the DR bit in the IOSR) */
  
  write_ptr &= SERIAL_BUF_LEN-1;    /* make shure that write_ptr was incremented mod SERIAL_BUF_LEN */

  auto_vu_count = (int)params[2][0];    /* restart counter; set to 0 or 1 depending on RevertToLevels */

    
  if(write_ptr==read_ptr || portfff6&0x2600){   /* Buffer was just overwritten or a break, framing error,
                                                   or receive overrun detected */
/*  if(write_ptr==read_ptr){    /* Buffer was just overwritten (FIX: garentee no overflow?) */
    serial_error_flag = 1;  /* flag serial comm. error for main() */
  }

  return;   /* get out as soon as possible (when full DSP utilization, we have been missing chars) */

}


#if(MAIN)
/***** Get Switch Action: *************************************************/
if(iosr_copy&0x00f0){   /* a delta (I/O pin state change) inturrupt occurred */
  /***** Set appropriate SW Action flags (sw_pressed, sw_released, cw, ccw): */
  sum2=0, io0_sum=0, io1_sum=0, io2_sum=0;  /* init. some vars. */

  io = iosr_copy;
  count_start = portfffa;       /* grab current timer value (for debounce interval timing) */
  while(delta_t(count_start)<SW_DEBOUNCE){  /* accumulate sw states over debounce interval (~1000uS) */
  /* while(sum<100) */
    io0_sum += 0x0001&io;       /* do runing sum of IO0 */
    io1_sum += 0x0001&(io>>1);  /* do runing sum of IO1 */
    io2_sum += 0x0001&(io>>2);  /* do runing sum of IO2 */
    io = portfff6;              /* read iosr */
    sum2++;
  }
  sum2 = sum2>>1;   /* divide sum by 2 */

  /* Update Switch and Rotary-Encoder Action parameters: */
  sw_down_old = sw_down;            /* keep sw_down history */
  sw_down = io2_sum<sum2;           /* get inverse of IO2, switch input bit */
  if(sw_down&&(!sw_down_old)){  /* determine if sw pressed or released based on states */
    sw_pressed = 1;
  }
  if((!sw_down)&&sw_down_old){
    sw_released = 1;
  }

#if(ENCODER_TYPE==0)    /* Panasonic */
  if(0x0010&iosr_copy){             /* quick return if only input 0 changed */
   return;
  }

  gray_code_old = gray_code; 
  gray_code = ((io1_sum>sum2)<<1)|(io0_sum>sum2);   /* get code for Rotary Encoder (0,1,3,2) */
  switch((gray_code_old<<2)|gray_code){
  case 3:
  case 12:
  case 7:
  case 8:
    ccw = 1;
    break;
  case 6:
  case 9:
  case 2:
  case 13:
    cw = 1;
    break;
  }
#else   /* Switch Channel */
  gray_code_old = gray_code; 
  gray_code = ((io1_sum>sum2)<<1)|(io0_sum>sum2);   /* get code for Rotary Encoder (0,1,3,2) */
  switch((gray_code_old<<2)|gray_code){
  case 7:
  case 8:
    cw = 1;
    break;
  case 4:
  case 11:
    ccw = 1;
    break;
  }
#endif

  /***** Done seting SW Action flags (sw_down, sw_pressed, sw_released, cw, ccw) *******/


  if(sw_pressed||cw||ccw){  /* if SW Action calls for a click sound: */
    port0_copy |= 0x0040;   /* Raise the IO10 (speaker bus) pin to click the speaker */
    port0 = port0_copy;
    auto_vu_count = (int)params[2][0];  /* restart counter; set to 0 or 1 depending on RevertToLevels */
  }

  /****** Update display and parameters in response to SW actions: *************/
  
  flash_cursor_flag = 1;    /* resume flashing currsor */
  
  nstart = (0x000f&(param_struct[param_ptr].flag>>10)) + 1; /* get nstart */
  type = param_struct[param_ptr].flag>>15;
  if(type){ /* display type: "text text" */
    n_offset = 0;
    nlength = 1;
    nfrac = 0;
  }
  else{     /* display type: "text int" or "text float" */
    n_offset = (0x0007&(param_struct[param_ptr].flag>>7));  /* get the cursor offset */
    nlength = 0x000f&(param_struct[param_ptr].flag>>3);
    nfrac = 0x0007&param_struct[param_ptr].flag;
  }
  
  if(sw_pressed&&(cursor_pos!=1)&&(0x4000&param_struct[param_ptr].flag)){ /* if press action param. */
    press_flag = 1; /* flag that knob was pressed on a press action param. */
    assembly_flag &= ~3;    /* turn off the VU Meter */
    disp_text("Press to        ", 1, -1);   /* write LCD and turn off cursor */
    /* Get current function text up to the ":" */
    for(i=0;i<7;i++){
      carray[i] = *(param_struct[param_ptr].text + i);
      if(carray[i]==':'){
        break;
      }
    }
    carray[i] = 0;  /* put null at end */
    disp_text(carray, 10, 0);   /* write function string to LCD */
    disp_text("",1, 0);         /* position cursor to left */
  }
  else if(press_flag){  /* if previosly flaged a press action */
    if(sw_pressed){
      params_changed = 3;   /* flag update_dsp() to carry out press action (code 3) */
      press_flag = 0;
    }
    else if(cw||ccw){
      disp_text("Cancelled       ", 1, 0);  /* write LCD */
      wait(750000);             /* wait .75 sec. */
      update_disp_left();       /* display parameter state */
      update_disp_right(1);
      press_flag = 0;
      /* make shure that the first knob turn after this msg. increments the display: */
      gray_code = 0x0003&portfff6;  /* put rotary encoder bits into gray_code so first sw action is taken */
      portfff6 = 0x00f0;            /* clear pending delta interrupts */
    }
  }
  else if(sw_pressed||(sw_down&&cw)){
    /* Increment cursor_pos to next valid position: */
    temp_pos = cursor_pos;
    if(temp_pos==1){
      temp_pos = nstart + n_offset;
    }
    else{
      ++temp_pos;
      if(temp_pos>=(nstart+nlength)){
        temp_pos = 1;
      }
      else if(nfrac&&(temp_pos==(nstart+nlength-nfrac-1))){ /* float with cursor on decimal point */
        ++temp_pos;
      }
    }
    disp_text("",temp_pos, +1); /* position cursor and turn on */
  } /* end if(sw_pressed||(sw_down&&cw)) */
  else if(sw_down&&ccw){
    /* Decrement cursor_pos to previous valid position: */
    temp_pos = cursor_pos;
    if(temp_pos==1){
      temp_pos = nstart + nlength - 1;
    }
    else{
      --temp_pos;
      if(temp_pos<nstart){
        temp_pos = 1;
      }
      else if(nfrac&&(temp_pos==(nstart+nlength-nfrac-1))){ /* float with cursor on decimal point */
        --temp_pos;
      }
    }
    disp_text("", temp_pos, +1);    /* position cursor and turn on */
  } /* end else if(sw_down&&ccw) */
  else if((cw||ccw)&&((assembly_flag&3)==3)){   /* if SW turned with auto VU mode active */
    assembly_flag &= ~3;    /* turn off the VU Meter */
    /* auto_vu_count = (int)params[2][0];   /* restart counter; set to 0 or 1 depending on RevertToLevels */
    update_disp_left();     /* write parameter text to LCD left */
    update_disp_right(cursor_pos_vu);   /* write parameter value to LCD right and reposition cursor */
    params_changed = 1; /* set change flag to update only min_value and max_value vars. */
  }
  else if((cw||ccw)&&(!down_turn_flag)){
    assembly_flag &= ~3;    /* turn off the VU Meter */
    /* auto_vu_count = (int)params[2][0];   /* restart counter; set to 0 or 1 depending on RevertToLevels */
    if(cursor_pos==1){  /* currsor on left */
      i = inc_dec_param_ptr();  /* increment/decrement param_ptr and update index_ab */
      update_disp_left();   /* write parameter text to LCD left */
      update_disp_right(1); /* write parameter value to LCD right */
      params_changed = 1;   /* set change flag to update only min_value and max_value vars. */
      if(i){    /* beep if a boudary was crossed in menu */
        beep(30, 550);
        wait(200000);   /* wait for human to respond to beep */
        /* make shure that the first knob turn after a beep increments the display: */
        gray_code = 0x0003&portfff6;    /* put rotary encoder bits into gray_code so first sw action is taken */
        portfff6 = 0x00f0;              /* clear pending delta interrupts */
      }
    }
    else{       /* currsor on right (somewhere), inc/dec parameter value: */
      if(type){ /* display type: "text text" */ 
        nlabel = 0x00ff&param_struct[param_ptr].flag;       /* get number of labels */
        i = (int)params[param_ptr][index_ab];   /* get current parameter value for A, B, or Common */
        inc_dec_mod(&i, nlabel);        /* and increment mod nlabel */
        params[param_ptr][index_ab] = (long)i;
      }     /* end if (type==1) */
      else{ /* type==0 */
        if(nfrac==0){   /* display type: "text int" */
          i = nstart + nlength - cursor_pos - 1;
        }
        else{           /* display type: "text float" */
          if(cursor_pos>=(nstart + nlength - nfrac)){   /* cursor to right of decimal point */
            i = nstart + nlength - cursor_pos - 1;
          }
          else{
            i = nstart + nlength - cursor_pos - 2;
          }
        }
        add_sub_pow(&params[param_ptr][index_ab], i);   /* add/sub 10^i to/from current parameter value */
      } /* end else type==0 */
      update_disp_right(cursor_pos);    /* write parameter value to LCD right */
      params_changed = 2;               /* set change flag to update all */
    } /* end else cursor on right (somewhere) */
  } /* end else if((cw||ccw)&&(!down_turn_flag)) */
  
  down_turn_flag = sw_down&&(cw||ccw);  /* set flag if knob was turned while pressed */
  
  /* Clear all SW Action flags: */
  sw_pressed = 0;
  sw_released = 0;
  cw = 0;
  ccw = 0;

  port0_copy &= ~0x0040;    /* Lower the IO10 (speaker bus) pin */
  port0 = port0_copy;

}   /* end if delta inturrupt */
#endif


}   /* return to asmembly and return from interrupt */


/**************************************************************************
 * reset_lcd
 *   This function resets the LCD, truns off the cursor and sends it home
 * and loads the CG RAM with bar graph characters.
 *
 **************************************************************************/
void reset_lcd(void)
{
int i, j;

/* Perform SW reset of display (incase hardware reset failed): */
write_lcd_nibble(0x3, 4100);    /* send 4 bit nibble to LCD instruction reg. */
write_lcd_nibble(0x3, 100);     /* send 4 bit nibble to LCD instruction reg. */
write_lcd_nibble(0x3, 100);     /* send 4 bit nibble to LCD instruction reg. */
write_lcd_nibble(0x2, 100);     /* send 4 bit nibble to LCD instruction reg. */

/* Set interface to 4 bits and put the display in known state: */
write_lcd_inst(0x28, 40);       /* Function Set: 4 bit data length, 5x7 dots */
write_lcd_inst(0x0c, 40);       /* Display On, Cursor Off */
cursor_flag = 0;                /* Clear cursor_flag */
flash_cursor_flag = 1;          /* normaly flash cursor */
write_lcd_inst(0x01, 1640);     /* Clear Display */
write_lcd_inst(0x06, 40);       /* Entry Mode Set: Increment cursor, no shift */
write_lcd_inst(0x02, 1640);     /* Cursor Home */

/* Load thermometer bar code graph into Character Generator RAM: */
write_lcd_inst(0x40, 40);   /* Set Character Generator Address to beginning */
for(i=7;i>=0;i--){
  for(j=1;j<9;j++){
    if(j<=i){
      write_lcd_data(0x00, 40); /* bar off */
    }
    else{
      write_lcd_data(0x0e, 40); /* bar on */
    }
  }
}

write_lcd_inst(0x80, 40);   /* Set Display Data Address to beginning (home) */
cursor_pos = 1;     /* Set global variable to current cursor position */

}

/**************************************************************************
 * disp_text
 *   This function writes a text string to the LCD.
 *
 *   *text      -   Text string to write to LCD display
 *                  (if null string -> cursor put into position)
 *   position   -   1 to 16 - Position of first character
 *                  Final cursor position: one character to the right of the
 *                  end of the string.
 *                  (out-of-limits not checked)
 *  cursor_on   -   Turns on/off curssor:
 *                  +1 - turns on cursor
 *                  -1 - turns off cursor
 *                   0 - cursor visibility not affected
 *
 * Possible speedup: Only update the part of the display that changed.
 *
 *************************************************************************/
void disp_text(char *text, int position, int cursor_on)
{
unsigned port_temp;

port_temp = portfff5;   /* save state of portfff5 */
portfff5 &= ~0x0200;    /* Suspend delta interrupts while updating display
                           This is because the delta int. also calls disp_text() and wait(). */

/* Turn on/off cursor: */
if((cursor_on>0)&&(!cursor_flag)){
  write_lcd_inst(0x0e, 40);     /* turn on cursor */
  cursor_flag = 1;              /* flag cursor on */
}
if((cursor_on<0)&&(cursor_flag)){
  write_lcd_inst(0x0c, 40);     /* turn off cursor */
  cursor_flag = 0;              /* flag cursor off */
}

if(position!=cursor_pos){   /* Put cursor in "position" if not there */
  if(position<9){
    write_lcd_inst((0x80 - 1) + position, 40);
    }
  else{
    write_lcd_inst((0xc0 - 9) + position, 40);
  }
  cursor_pos = position;
}
/* Write characters: */
while(*text!='\0'){ /* loop while not end of string (not null character) */
  write_lcd_data(*text++, 40);
  cursor_pos++;
  if(cursor_pos==9){
    write_lcd_inst(0xc0, 40);/* put the cursor in location 8 */
  }
}
portfff5 = port_temp;   /* restore state of portfff5 (could unmask delta interrupts) */
}


 /**************************************************************************
 * disp_num
 *   This function writes a number to the LCD. The number is a long and
 * can appear as an integer: e.g. 123 or as a float: e.g. 32.45
 *
 *   num        -   number to write to LCD display
 *   position   -   1 to 16 - Position of first character (#, -, or space)
 *                  Final cursor position: one character to the right of the
 *                  end of the string
 *                  (out-of-limits not checked)
 *   width      -   Total field width of displed number
 *                  e.g. for num = -26745 (and nfrac=0)
 *                  width=6 -> "-26745"
 *                        7 -> " -26745"
 *                        5 -> "*****"
 *  nfrac       -   number of nfractional digits, number of digits to the right of the
 *                  decimal point.
 *                  e.g. for num = -26745 (and width=7)
 *                  nfrac=0 ->  " -26745"
 *                  nfrac=1 ->  "-2674.5"
 *                  nfrac=5 ->  "-.26745"
 *                  nfrac=6 ->  "-.02674" ?
 *
 **************************************************************************/
void disp_num(long num, int position, int width, int nfrac)
{

char tempc[17];
char *text;
int i, strlength;

text = num2string(num, nfrac, &strlength, (char*)&tempc);   /* convert number to string */

/* Check for field overflow and write "***...**" if overfull: */
if(strlength>width){
  text = &tempc[16];    /* point to last charracter in array */
  for(i=0;i<width;i++){
    *--text = '*';      /* fill with *'s if field overflowed */
  }
}
/* Add leading spaces if necesary: */
while(width>strlength++){
  *--text = ' ';
}      

/* Display text at *bufptr */
disp_text(text, position, 0);

}


 /**************************************************************************
 * num2string
 *   This function converts a number to a string. The number is a long and
 * is converted as an integer: e.g. 123 or as a float: e.g. 32.45
 *
 *  num         -   number to write to convert
 *  nfrac       -   number of nfractional digits, number of digits to the right of the
 *                  decimal point.
 *                  e.g. for num = -26745
 *                  nfrac=0 ->  "-26745"
 *                  nfrac=1 ->  "-2674.5"
 *                  nfrac=5 ->  "-.26745"
 *  *strlength  -   returns length of resulting string (not counting terminating null)
 *  *str17      -   pointer to begining of string array buffer
 *                  (Important: length must be 17 elements)
 *
 **************************************************************************/
char* num2string(long num, int nfrac, int *strlength, char *str17)
{
char *bufptr;
int neg = num < 0;
long unum = neg ? -num : num;   /* take absolute value */

bufptr = (str17+16);    /* point to end of charracter array */
*bufptr = 0;            /* put null character at end of charracter array */
*strlength = 0;         /* start string length counter */
/* Convert integer and load array: */
do{
  *--bufptr = (unum % 10) + '0';    /* next LS digit, add to code for 0 and store in array */
  (*strlength)++;           /* inc. strlength */
  if(*strlength==nfrac){
    *--bufptr = '.';        /* insert decimal point if fraction */
    (*strlength)++;         /* inc. strlength */
    nfrac = 0;              /* flag fact that decimal point has been inserted */
  }
} while((unum/=10)||nfrac);

/* Insert minus sign if negative: */
if(neg){
  *--bufptr = '-';
  (*strlength)++;           /* inc. strlength */
}

return bufptr;
}

/**************************************************************************
 * write_lcd_inst
 *   This function writes a byte into the LCD's instruction register (RS low)
 *
 *   byte       -   input instruction byte
 *   delay_usec -   wait time after instruction write (in micro-seconds)
 *                  valid range: 10 to 32,767 usec
 *                               0 - for minimal delay
 *
 *   This function does not efect the 2 MSBs of port0 (IO10 and IO11).
 **************************************************************************/
void write_lcd_inst(int byte, int wait_usec)
{
int i, iend, nibh, nibl;

nibh = (byte&0xf0)>>4;  /* get high and low nibbles */
nibl = byte&0x0f;

port0_copy = port0_copy&(~0x10);        /* Lower the RS pin */
port0 = port0_copy;


port0_copy = (0xd0&port0_copy)|0x20|nibh; /* Raise E pin on LCD and write low */
port0 = port0_copy;

port0_copy = (0xd0&port0_copy)|nibh;    /* Lower E pin on LCD and hold low */
port0 = port0_copy;


port0_copy = (0xd0&port0_copy)|0x20|nibl; /* Raise E pin on LCD and write high */
port0 = port0_copy;

port0_copy = (0xd0&port0_copy)|nibl;    /* Lower E pin on LCD and hold high */
port0 = port0_copy;

wait((long)wait_usec);                      /* wait here for LCD not bussy */
}

/**************************************************************************
 * write_lcd_data
 *   This function writes a byte into the LCD's data register (RS high)
 *
 *   byte       -   input data byte
 *   wait_usec -    wait time after data write (in micro-seconds)
 *                  valid range: 10 to 32,767 usec
 *                               0 - for minimal delay
 *
 *   This function does not efect the 2 MSBs of port0 (IO10 and IO11).
 **************************************************************************/
void write_lcd_data(int byte, int wait_usec)
{
int i, iend, nibh, nibl;

nibh = (byte&0xf0)>>4;  /* get high and low nibbles */
nibl = byte&0x0f;

port0_copy = port0_copy|0x10;       /* Raise the RS pin */
port0 = port0_copy;


port0_copy = (0xd0&port0_copy)|0x20|nibh; /* Raise E pin on LCD and write low */
port0 = port0_copy;

port0_copy = (0xd0&port0_copy)|nibh;    /* Lower E pin on LCD and hold low */
port0 = port0_copy;


port0_copy = (0xd0&port0_copy)|0x20|nibl; /* Raise E pin on LCD and write high */
port0 = port0_copy;

port0_copy = (0xd0&port0_copy)|nibl;    /* Lower E pin on LCD and hold high */
port0 = port0_copy;

wait((long)wait_usec);                      /* wait here for LCD not bussy */
}

/**************************************************************************
 * write_lcd_nibble
 *   This function writes a 4-bit nibble into the LCD's instruction register
 *
 *   nibble     -   input instruction nibble
 *   delay_usec -   wait time after instruction write (in micro-seconds)
 *                  valid range: 10 to 32,767 usec
 *                               0 - for minimal delay
 *
 *   This function does not efect the 2 MSBs of port0 (IO10 and IO11).
 **************************************************************************/
void write_lcd_nibble(int nibble, int wait_usec)
{
int i, iend;

port0_copy = port0_copy&(~0x10);        /* Lower the RS pin */
port0 = port0_copy;

port0_copy = (0xd0&port0_copy)|0x20|nibble; /* Raise E pin on LCD and write */
port0 = port0_copy;
port0_copy = (0xd0&port0_copy)|nibble;  /* Lower E pin on LCD and hold */
port0 = port0_copy;

wait((long)wait_usec);                      /* wait here for LCD not bussy */
}



/**************************************************************************
 * delta_t
 * Returns time in ~microseconds since count_start.
 * In this case a ~microsecond is about 1.058 true microseconds.
 * Returns 0 to 32767. Rolls over if more that 32767us has ellapsed.
 *
 **************************************************************************/
int delta_t(unsigned count_start)
{
int itemp;

itemp = (count_start>>1) - (portfffa>>1);       /* compute difference in ~microseconds */
                                                /* if itemp pos. => timer didn't wrap around */
                                                /* if itemp neg. => timer wraped, correct below: */
return ((itemp>=0) ? itemp:(itemp + 0x8000));   /* compute and return ellapsed time */

}


/**************************************************************************
 * wait
 * Wait for wait_usec ~microseconds. In this case a ~microsecond is about
 * 1.0579 true microseconds. Call overhead and ISR's could slightly
 * extend the wait time.
 *
 *                  valid range: ~20 to 500,000,000 usec
 *                               0 - for minimal delay 
 *
 **************************************************************************/
void wait(long wait_usec)
{
int i, wait_course, wait_fine;
unsigned count_start;

/* Get course and fine time variables: */
wait_course = (int) (wait_usec>>14);        /* get course wait (multiples of 16384) */
wait_fine = (int) (wait_usec&0x00003fff);   /* get fine wait time */

count_start = portfffa;     /* grab current timer value (for interval timing) */
while(delta_t(count_start)<wait_fine);

if(wait_course==0) return;

/* Wait for an additional (wait_course*16384us): */
for(i=0;i<wait_course;i++){
  count_start = portfffa;       /* grab current timer value (for interval timing) */
  while(delta_t(count_start)<16384);
}
  

}

/**************************************************************************
 * wait_n_samples
 * Wait for n sampling intervals 
 *
 **************************************************************************/
void wait_n_samples(int n)
{
wait(n*1000000/((long)fsample));    /* wait for ~four sampling intervals for CODEC updates */

}


/**************************************************************************
 * prog_flash
 * IMPORTANT: set func_addr_a and _b to no_func_a and _b before calling
 * (because of added wait states below)!
 * This function programs the Am29F010 FLASH memory. 32K Bytes of FLASH memory
 * is mapped to the global address space of the DSP starting at address 0x8000.
 * One of four possible blocks of FLASH are mapped to the DSP depending on the
 * IO2 and CLIPA pin levels. 32K Bytes represents two independently erasable FLASH
 * sectors.
 *
 * This function stores 16 bit words in two consecutive FLASH locations
 * with high byte stored first.
 *
 * The FLASH is logically organized into words as follows:
 * Address range        IO2 CLIPA   Use         Sector
 * 0x0000 to 0x1fff     1   0   -   CODE (Main) sector 0 (8K words)(see p. 4-16 Users Guide for required format)
 * 0x2000 to 0x3fff             -   CODE (Main) sector 1 (8K words)
 *
 * 0x4000 to 0x5fff     1   1   -   CODE (Main) sector 2 (8K words)
 * 0x6000 to 0x7fff             -   DATA        sector 3 (8K words)
 *
 * 0x8000 to 0x9fff     0   0   -   CODE (Backup) sector 4 (8K words) - Boots when button down
 * 0xa000 to 0xbfff             -   CODE (Backup) sector 5 (8K words)
 *
 * 0xc000 to 0xdfff     0   1   -   CODE (Backup) sector 7 (8K words)
 * 0xe000 to 0xffff             -   SPARE       sector 8 (8K words)
 *
 *  start   -   Starting word location of FLASH storage to program (0 to 0xffff)
 *  length  -   Length in words to program (1 to 0x2000)
 *              (don't span sectors with input range)
 *  datawords - Pointer to data array
 *  erase_flag- 1 - erases (sets to 0xffff's) entire sector before programming
 *              0 - programs without erassing (only use if known to be errased)
 *  error_text- Text pointer to indicate the location that prog_flash was called from.
 *              should be 8 characters. eg. "in Store"
 *
 * Returns:     0 - programmed OK
 *              1 - programming error
 *
 *
 *  Error codes:0 - programmed OK
 *              1 - parameter error (or flash_locked = 1)
 *              2 - erase timeout error
 *              3 - erase verify error
 *              4 - programming 0->1 error, must erase first
 *              5 - programming timeout error
 *              6 - programming DATA section error: can't set CLIPA bit
 *                  (or FLASH was incorrectly programmed preveiously)
 *
 **************************************************************************/
prog_flash(unsigned start, unsigned length, unsigned *datawords, int erase_flag, char *error_text)
{
unsigned i, j, status1, status2, word, byte, xbyte, sector_start, port_temp;
char carray[10];
long error_code=0;

if(flash_locked){   /* return */
  error_code = 1;
  goto prog_error;
}

port_temp = portfff5;   /* save state of portfff5 */
portfff5 &= ~0x0200;    /* mask delta interrupts (if not) */
portfff5 |= 0x0004;     /* make IO2 an output (if not) */

if(start<0x4000){       /* set: IO2 = 1, CLIPA = 0 */
  portfff6 = (portfff6&0x000f)|0x0004;  /* and set IO2 */
  out_atten &= ~0x000c; /* clear CLIP LEDs (if not) */
}
else if(start<0x8000){  /* set: IO2 = 1, CLIPA = 1 */
  start -= 0x4000;
  portfff6 = (portfff6&0x000f)|0x0004;  /* and set IO2 */
  out_atten |= 0x000c;  /* set CLIP LEDs */
}
else if(start<0xc000){  /* set: IO2 = 0, CLIPA = 0 */
  start -= 0x8000;
  portfff6 &= 0x000b;   /* and clear IO2 */
  out_atten &= ~0x000c; /* clear CLIP LEDs (if not) */
}
else{                   /* set: IO2 = 0, CLIPA = 1 */
  start -= 0xc000;
  portfff6 &= 0x000b;   /* and clear IO2 */
  out_atten |= 0x000c;  /* set CLIP LEDs */
}

wait_n_samples(20);     /* wait for ~20 sampling intervals for CLIP signals to propagate */
                        /* wait for I02 state to settle (4 RC's = 4*10K*0.01uF) */
                        
if(((start<0x2000)&&((start+length)>0x2000))||((start>=0x2000)&&((start+length)>0x4000))){
  error_code = 1;   /* parameter error */
  goto prog_error;
}

*greg_ptr = 0x0080; /* map flash memory to global data space: 0x8000 to 0xffff */ 
portfffc = (IO_WAITS*0x0200 + FLASH_WAITS*0x0040 + 0*0x0008 + 0);   /* Increase # wait states in data mem. */
/* Warning increasing wait states can keep the ISR from completing */

*((unsigned int *)(0x8000+0x5555)) = 0x00aa;    /* put FLASH into normal read state */
*((unsigned int *)(0x8000+0x2aaa)) = 0x0055;
*((unsigned int *)(0x8000+0x5555)) = 0x00f0;

if(out_atten&0x0008){   /* If CLIPA should be set: */
  /* Verify that CLIPA signal was actualy set by making sure that the FLASH serial number */
  /* is not present in FLASH memory space. This avoids accidently overwriting CODE memory. */

  /* Read serial number section from FLASH: */
  j = 0;
  for(i=(2*SERIAL_LOC)+4;i<(2*SERIAL_LOC)+4+10;i++){
    carray[j++] = (*((unsigned int *)(0x8000+i)))&0x00ff;   /* get bytes from FLASH */
  }
  if(valid_serial(carray)){ /* error if valid serial number found here */
    error_code = 6;
    goto prog_error;
  }
}

if(erase_flag){ /* Erase FLASH sector(s): */
  if(start<0x2000){
    sector_start = 0x0000;
  }
  else{
    sector_start = 0x4000;
  }
  
  /* Erase sector 0 or 1 (depending on sector_start): */
  *((unsigned int *)(0x8000+0x5555)) = 0x00aa;  /* write unlock code to FLASH */
  *((unsigned int *)(0x8000+0x2aaa)) = 0x0055;
  *((unsigned int *)(0x8000+0x5555)) = 0x0080;
  *((unsigned int *)(0x8000+0x5555)) = 0x00aa;
  *((unsigned int *)(0x8000+0x2aaa)) = 0x0055;
  *((unsigned int *)(0x8000+sector_start)) = 0x0030;    /* write command to erase sector 0 */
  wait(100);    /* wait 100 uS */
  do{
    status1 = *((unsigned int *)(0x8000+sector_start)); /* read two consecutive status bytes */
    status2 = *((unsigned int *)(0x8000+sector_start));
    if(((status1&0x0040)==(status2&0x0040))||(status1&0x0080)){ /* no change in DQ6: done toggling */
      goto pf_1;                                                /* or DQ7==1 */
    }
  }
  while(!(status1&0x00020));    /* loop unless timeout (DQ5==1) */
  status1 = *((unsigned int *)(0x8000+sector_start));   /* read two consecutive status bytes */
  if(status1&0x0080){   /* DQ7==1 */
    goto pf_1;
  }
  error_code = 2;   /* erase timeout error */
  goto prog_error;
 pf_1:
  *((unsigned int *)(0x8000+0x5555)) = 0x00aa;  /* put FLASH into normal read state */
  *((unsigned int *)(0x8000+0x2aaa)) = 0x0055;
  *((unsigned int *)(0x8000+0x5555)) = 0x00f0;
  /* Varify FLASH erased: */
  for(i=sector_start;i<(0x4000+sector_start);i++){
    if(((*((unsigned int *)(0x8000+i)))&0x00ff)!=0x00ff){
      error_code = 3;   /* not erased error */
      goto prog_error;
    }
  }
}

/* Program FLASH: */
j = 0;
start = (start<<1);             /* set start to point to the starting word in FLASH */
length = start + (length<<1);   /* set length to last FLASH address + 1 */
for(i=start;i<length;i++){
  if(i&0x0001){ /* i odd */
    byte = word&0x00ff;         /* get LS byte */
  }
  else{     /* i even */
    word = datawords[j++];      /* get current word */
    byte = word>>8;             /* get MS byte */
  }
  *((unsigned int *)(0x8000+0x5555)) = 0x00aa;  /* put FLASH into normal read state */
  *((unsigned int *)(0x8000+0x2aaa)) = 0x0055;
  *((unsigned int *)(0x8000+0x5555)) = 0x00f0;
  xbyte = (*((unsigned int *)(0x8000+i))^byte)&0x00ff;  /* current FLASH byte XOR with desired data */
  if(xbyte){        /* data is different: must reprogram byte */
    if(xbyte&byte){ /* error: can't program 0 bit to 1 bit */
      error_code = 4;   /* programming 0 to 1 error */
      goto prog_error;
    }
    *((unsigned int *)(0x8000+0x5555)) = 0x00aa;    /* write unlock code to FLASH */
    *((unsigned int *)(0x8000+0x2aaa)) = 0x0055;
    *((unsigned int *)(0x8000+0x5555)) = 0x00a0;
    *((unsigned int *)(0x8000+i)) = byte;   /* program FLASH byte */
    do{ /* !data polling */
      status1 = *((unsigned int *)(0x8000+i));
      status2 = *((unsigned int *)(0x8000+i));
      if(((status1&0x0040)==(status2&0x0040))||((status1&0x0080)==(byte&0x0080))){  /* no change in DQ6 */
        goto pf_3;                                                                  /* or DQ7==DATA7 */
      }
    }
    while(!(status1&0x00020));  /* loop unless timeout (DQ5==1) */
    status1 = *((unsigned int *)(0x8000+i));
    if((status1&0x0080)==(byte&0x0080)){        /* done */
      goto pf_3;
    }
    error_code = 5; /* programming timeout error */
    goto prog_error;
  }
  pf_3:
  continue;
}

prog_out:
portfffc = (IO_WAITS*0x0200 + 0*0x0040 + 0*0x0008 + 0); /* back to 0 wait states in data mem. */

portfff5 &= ~0x0004;    /* make IO2 an input */
wait(400);              /* wait for I02 to go high (4 RC's = 4*10K*0.01uF) */
portfff6 = 0x00f0;      /* clear pending delta interrupts */
portfff5 = port_temp;   /* restore state of portfff5 (could unmask delta interrupts) */
out_atten &= ~0x000c;   /* clear CLIP LEDs (if not) */
flash_locked=1;         /* lockout accidental FLASH programming */

if(error_code){
  return 1;             /* error */
}
else{
  return 0;             /* success */
}


prog_error:
*((unsigned int *)(0x8000+0x5555)) = 0x00aa;    /* put FLASH into normal read state */
*((unsigned int *)(0x8000+0x2aaa)) = 0x0055;
*((unsigned int *)(0x8000+0x5555)) = 0x00f0;

/*portfff5 &= ~0x0200;  /* suspend delta interrupts while updating display */
disp_text("ProgERR", 1, -1);
disp_num(error_code, 8, 1, 0);
disp_text(error_text, 9, -1);
/*portfff5 |= 0x0200;   /* re-enable delta interupts */

wait(2000000);
goto prog_out;

}


/**************************************************************************
 * read_flash
 * IMPORTANT: set func_addr_a and _b to no_func_a and _b before calling
 * (because of added wait states below)!
 * This function reads the Am29F010 FLASH memory. 32K Bytes of FLASH memory
 * is mapped to the global address space of the DSP starting at address 0x8000.
 * This function retrieves 16 bit words from two consecutive FLASH locations
 * with high byte stored first.
 *
 *  start   -   Starting word location of FLASH storage to retreive (0 to 0xffff)
 *  length  -   Length in words to retreive (1 to 0x2000)
 *              (don't span from 0x3fff-0x4000 (or similar) with input range)
 *  datawords - Pointer to data array
 *
 **************************************************************************/
void read_flash(unsigned start, unsigned length, unsigned *datawords)
{
unsigned i, j, port_temp;

port_temp = portfff5;   /* save state of portfff5 */
portfff5 &= ~0x0200;    /* mask delta interrupts (if not) */
portfff5 |= 0x0004;     /* make IO2 an output (if not) */

if(start<0x4000){       /* set: IO2 = 1, CLIPA = 0 */
  portfff6 = (portfff6&0x000f)|0x0004;  /* and set IO2 */
  out_atten &= ~0x000c; /* clear CLIP LEDs (if not) */
}
else if(start<0x8000){  /* set: IO2 = 1, CLIPA = 1 */
  start -= 0x4000;
  portfff6 = (portfff6&0x000f)|0x0004;  /* and set IO2 */
  out_atten |= 0x000c;  /* set CLIP LEDs */
}
else if(start<0xc000){  /* set: IO2 = 0, CLIPA = 0 */
  start -= 0x8000;
  portfff6 &= 0x000b;   /* and clear IO2 */
  out_atten &= ~0x000c; /* clear CLIP LEDs (if not) */
}
else{                   /* set: IO2 = 0, CLIPA = 1 */
  start -= 0xc000;
  portfff6 &= 0x000b;   /* and clear IO2 */
  out_atten |= 0x000c;  /* set CLIP LEDs */
}

wait_n_samples(20);     /* wait for ~20 sampling intervals for CLIP signals to propagate */
                        /* wait for I02 state to settle (4 RC's = 4*10K*0.01uF) */
                        
*greg_ptr = 0x0080; /* map flash memory to global data space: 0x8000 to 0xffff */ 
portfffc = (IO_WAITS*0x0200 + FLASH_WAITS*0x0040 + 0*0x0008 + 0);   /* Increase # wait states in data mem. */
/* Warning increasing wait states can keep the ISR from completing */

*((unsigned int *)(0x8000+0x5555)) = 0x00aa;    /* put FLASH into normal read state (if should already be there) */
*((unsigned int *)(0x8000+0x2aaa)) = 0x0055;
*((unsigned int *)(0x8000+0x5555)) = 0x00f0;

/* Read FLASH: */
j = 0;
start = (start<<1);             /* set start to point to the starting byte in FLASH */
length = start + (length<<1);   /* set length to last FLASH address + 1 */
for(i=start;i<length;i+=2){
  datawords[j++] = ((*((unsigned int *)(0x8000+i)))<<8) | ((*((unsigned int *)(0x8001+i))&0x00ff)); /* build word */
}

portfffc = (IO_WAITS*0x0200 + 0*0x0040 + 0*0x0008 + 0); /* back to 0 wait states in data mem. */

portfff5 &= ~0x0004;    /* make IO2 an input */
wait(400);              /* wait for I02 to go high (4 RC's = 4*10K*0.01uF) */
portfff6 = 0x00f0;      /* clear pending delta interrupts */
portfff5 = port_temp;   /* restore state of portfff5 (could unmask delta interrupts) */
out_atten &= ~0x000c;   /* clear CLIP LEDs (if not) */

}


/**************************************************************************
 * valid_serial
 * This function returns a 1 if the serial number string is valid
 * and a 0 if not valid.
 *
 * A valid serial number consists of 6 digits followed by 4 check digits:
 *
 *      0123456789
 *      ######oess  -   SN with check sums
 *
 *      ######  -   6 digit SN eg. 132001
 *      o       -   check sum of # # #  (odd digits) modulo 10
 *      e       -   check sum of  # # # (even digits) modulo 10
 *      ss      -   check sum of ######oe
 *
 **************************************************************************/
int valid_serial(char *carray)
{
int i, code, num[10], sumo=0, sume=0, sumss=0;

for(i=0;i<10;i++){
  code = carray[i]; /* get */
  num[i] = code - 0x30; /* convert to decimal and save */
  if((code<0x30)||(code>0x39)){
    return 0;   /* error, not ASCII digit 0 to 9 */
  }
}

sumo = num[0]+num[2]+num[4];
/* sumo = sumo % 10;            /* sum = sum modulo 10 */
while(sumo>=10){
  sumo -= 10;
}

sume = num[1]+num[3]+num[5];
/* sume = sume % 10;            /* sum = sum modulo 10 */
while(sume>=10){
  sume -= 10;
}

sumss = num[0]+num[1]+num[2]+num[3]+num[4]+num[5]+sumo+sume;

if((sumo!=num[6])||(sume!=num[7])||(sumss!=(10*num[8]+num[9]))){
  return 0;     /* checksum error */
}

return 1;       /* checksum OK */
}


/**************************************************************************
 * update_disp_left
 * Updates (writes) the left side of the LCD after striping "#" and "."
 * from the .text string.
 **************************************************************************/
void update_disp_left(void)
{
#if(MAIN)

#define BUFL 17

int i, pos, pos2;
char ctemp, ctemp1[BUFL], ctemp2[BUFL];
char *c1ptr, *c2ptr;

c1ptr = &ctemp1[0]; /* set pointers */
c2ptr = &ctemp2[0];
  
pos = 0;
do{
  ctemp = (*(c1ptr++) = *(param_struct[param_ptr].text + (pos++))); /* copy chars */
} while((ctemp!='#')&&(ctemp!='\0'));

if(ctemp=='\0'){
  disp_text(ctemp1, 1, -1); /* Found no #'s. Write left side LCD only (no chars on right) */
}
else{   /* '#' found */
  *(c1ptr-1) = '\0';    /* replace the '#' in *(c1ptr) with NULL */
  pos2 = 0;
  do{
    ctemp = *(param_struct[param_ptr].text + (pos++));  /* copy chars */
    if((ctemp!='#')&&(ctemp!='_')&&(ctemp!='.')&&(ctemp!='\0')&&(pos2==0)){
      pos2 = pos;
    }
    if(pos2){
      *(c2ptr++) = ctemp;   /* copy chars */
    }
  } while(ctemp!='\0');
  
  if(pos2!=0){
    disp_text(ctemp2, pos2, -1);    /* write right side of LCD with the text right of #.# */
  }
  disp_text(ctemp1, 1, -1);         /* write left side LCD (order puts cursor_pos in place for #.# */
}

if(flag_options==0){    /* if not in options section */
  if(index_ab==0){
    disp_text("a", 1, 0);   /* Write the A function indicator character */
  }
  else if(index_ab==1){
    disp_text("b", 1, 0);   /* Write the B function indicator character */
  }
  else if(index_ab==2){
    disp_text(" ", 1, 0);   /* Write the Common function indicator character */
  }
}

#endif
}

/**************************************************************************
 * update_disp_right
 * Updates (writes) the right side of the LCD with text or a number
 * depending on type.
 * Cursor is put back into pos and turned on prior to retrun.
 **************************************************************************/
void update_disp_right(int pos)
{
#if(MAIN)

int type, nstart, nlength, nfrac;

type = param_struct[param_ptr].flag>>15;
nstart = (0x000f&(param_struct[param_ptr].flag>>10)) + 1;

if(type){   /* display type: "text text" */
  disp_text((char*)(*(char*)(param_struct[param_ptr].label + params[param_ptr][index_ab])), nstart, 0);
}
else{       /* display type: "text int" or "text float" */
  nlength = 0x000f&(param_struct[param_ptr].flag>>3);
  nfrac = 0x0007&param_struct[param_ptr].flag;
  disp_num(params[param_ptr][index_ab], nstart, nlength, nfrac);
}

disp_text("", pos , +1);    /* put cursor back into position and turn on */

#endif
}


/**************************************************************************
 * beep
 * Beep the speaker.
 *
 **************************************************************************/
void beep(unsigned duration, unsigned period)
{
int i;

for(i=0;i<duration;i++){
  port0_copy |= 0x0040;
  port0 = port0_copy;
  wait(period);
  port0_copy &= ~0x0040;
  port0 = port0_copy;
  wait(period);
}

}





/*========= Required only by MAIN ========================================*/
#if(MAIN)



/**************************************************************************
 * store_all
 * This subroutine stores the current setting to all flash memory locations.
 *
 **************************************************************************/
void store_all(void)
{

int itemp;

record[0] = 0xffff;
flash_locked = 0;   /* unlock flash */
itemp = prog_flash(0x6000, 1, record, 1, "in Erase");   /* erase FLASH */
if(itemp==0){   /* if no error */
  for(itemp=LAST_MEM_LOC;itemp>=0;itemp--){
    params[10][0] = itemp;  /* load store location value */
    params_changed_copy = 3;
    store();                /* store current settings */
  }  
}
}

/**************************************************************************
 * xmit
 * This subroutine transimits the text string out of the RS-232 port
 * and follows with a charage return.
 *
 **************************************************************************/
void xmit(char *text)
{

portfff5 &= ~0x0080;    /* suspend async. receive ints. so this module
                           will not hear itself talking. This avoids serial
                           receive buffer overflows. */

while(*text!='\0'){
  while(!(portfff6&0x1000));/* hold here until ADTR and AXSR are empty */
  portfff4 = *text++;       /* send character out the RS-232 port */
}
portfff4 = '\r';    /* send CR last */
while(!(portfff6&0x1000));/* hold here until ADTR and AXSR are empty (CR sent) */

portfff6 = 0x6700;      /* reset any async. serial port interrupt indicator bits */
portfff5 |= 0x0080;     /* re-enable receive ints. */

}


/**************************************************************************
 * param_struct_search()
 * This function searches param_struct[i].text for a parameter_str[] 
 * match as follows:
 *
 * match_type = 0   -   no match found
 *              1   -   0-offset match
 *              2   -   0-offset match except with space in first .text
 *                          " APgain"=="bAPgain"
 *              3   -   1-offset match with space in first .text
 *                          " APgain"=="APgain"
 *
 **************************************************************************/
int param_struct_search(int *match_type)
{
int i;
char *cptr;

for(i=0;i<NPARAMSTRUCT;i++){            /* Search param_struct[i].text: */

  cptr = param_struct[i].text;  /* get pointer value to beginning of ith parameter text */

  if(string_compare(cptr, &parameter_str[0])){  /* if 0-offset match */
    *match_type = 1;
    return(i);
  }
  else if(*cptr++==' '){        /* first character is a space */
    if(string_compare(cptr, &parameter_str[0])){    /* if 1-offset match */
      *match_type = 3;
      return(i);
    }
    if(string_compare(cptr, &parameter_str[1])){    /* if 0-offset match (skipping first character) */
      *match_type = 2;
      return(i);
    }
  }
}

*match_type = 0;    /* no match found */
return(0);
}

/**************************************************************************
 * string_compare()
 * This function first converts both string to lower case and then compares
 * the strings up to end of the shortest string. Returns 1 if equal and
 * 0 if not equal. A null string matches anything.
 **************************************************************************/
int string_compare(char *s1, char *s2)
{
char ctemp1, ctemp2;
  
for(;;){
  ctemp1 = tolower(*s1++);
  ctemp2 = tolower(*s2++);
  if((!ctemp1)||(!ctemp2)) return(1);
  if(ctemp1 != ctemp2) return(0);
}
}


/**************************************************************************
 * inc_dec_param_ptr
 * Increment/Decrement param_ptr and set index_ab based on cw
 *
 * If Mode:A&B Common then the sequence is:
 *  Section index_ab    flag_options    param_ptr (name)        return 1 for beep
 *
 *  Common  2           0               0   (FUNC)              beep
 *                                      param_ptr_start[func_c]
 *                                      . . .
 *                                      param_ptr_end[func_c]   
 *  Options 0           1               OPTIONS_START           beep
 *                                      . . .
 *                                      OPTIONS_END
 *
 * If Mode:A&B Separate then the sequence is:
 *  Section index_ab    flag_options    param_ptr (name)        return 1 for beep
 *
 *  A       0           0               0   (FUNC)              beep
 *                                      param_ptr_start[func_a]
 *                                      . . .
 *                                      param_ptr_end[func_a]   
 *  B       1           0               0   (FUNC)              beep
 *                                      param_ptr_start[func_b]
 *                                      . . .
 *                                      param_ptr_end[func_b]
 *  Options 0           1               OPTIONS_START           beep
 *                                      . . .
 *                                      OPTIONS_END
 *
 * If Mode: Ch A Only then the sequence is:
 *  Section index_ab    flag_options    param_ptr (name)        return 1 for beep
 *
 *  A       0           0               0   (FUNC)              beep
 *                                      param_ptr_start[func_a]
 *                                      . . .
 *                                      param_ptr_end[func_a]   
 *  Options 0           1               OPTIONS_START           beep
 *                                      . . .
 *                                      OPTIONS_END
 *
 * Returns: 0 - if no boundary crossed
 *          1 - if boundary crossed: A <=> B <=> Options, or Common <=> Options ...
 **************************************************************************/
int inc_dec_param_ptr(void)
{
int func_a, func_b, func_c;

func_a = (int)params[0][0]; /* get A function index */
func_b = (int)params[0][1]; /* get B function index */
func_c = (int)params[0][2]; /* get Common function index */

switch((params[6][0]<<2)+(cw<<1)+flag_options){ /* compute a code for the switch */
case 0:     /* A&BCommon, ccw, flag_options=0 */
  if(param_ptr==0){
    param_ptr = OPTIONS_END;
    index_ab = 0;
    flag_options = 1;
  }
  else if(param_ptr==param_ptr_start[func_c]){
    param_ptr = 0;
    return 1;
  }
  else{
    param_ptr--;
  }
  break;

case 1:     /* A&BCommon, ccw, flag_options=1 */
  if(param_ptr==OPTIONS_START){
    param_ptr = param_ptr_end[func_c];
    index_ab = 2;
    flag_options = 0;
  }
  else{
    param_ptr--;
    if(param_ptr==OPTIONS_START){
      return 1;
    }
  }
  break;

case 2:     /* A&BCommon, cw, flag_options=0 */
  if(param_ptr==0){
    param_ptr = param_ptr_start[func_c];
  }
  else if(param_ptr==param_ptr_end[func_c]){
    param_ptr = OPTIONS_START;
    index_ab = 0;
    flag_options = 1;
    return 1;
  }
  else{
    param_ptr++;
  }
  break;

case 3:     /* A&BCommon, cw, flag_options=1 */
  if(param_ptr==OPTIONS_END){
    param_ptr = 0;
    index_ab = 2;
    flag_options = 0;
    return 1;
  }
  else{
    param_ptr++;
  }
  break;

case 4:     /* A&BSeparate, ccw, flag_options=0 */
  if(index_ab){
    if(param_ptr==0){
      param_ptr = param_ptr_end[func_a];
      index_ab = 0;
    }
    else if(param_ptr==param_ptr_start[func_b]){
      param_ptr = 0;
      return 1;
    }
    else{
      param_ptr--;
    }
  }
  else{ /* index_ab==0 */
    if(param_ptr==0){
      param_ptr = OPTIONS_END;
      index_ab = 0;
      flag_options = 1;
    }
    else if(param_ptr==param_ptr_start[func_a]){
      param_ptr = 0;
      return 1;
    }
    else{
      param_ptr--;
    }
  }
  break;

case 5:     /* A&BSeparate, ccw, flag_options=1 */
  if(param_ptr==OPTIONS_START){
    param_ptr = param_ptr_end[func_b];
    index_ab = 1;
    flag_options = 0;
  }
  else{
    param_ptr--;
    if(param_ptr==OPTIONS_START){
      return 1;
    }
  }
  break;

case 6:     /* A&BSeparate, cw, flag_options=0 */
  if(index_ab){
    if(param_ptr==0){
      param_ptr = param_ptr_start[func_b];
    }
    else if(param_ptr==param_ptr_end[func_b]){
      param_ptr = OPTIONS_START;
      index_ab = 0;
      flag_options = 1;
      return 1;
    }
    else{
      param_ptr++;
    }
  }
  else{ /* index_ab==0 */
    if(param_ptr==0){
      param_ptr = param_ptr_start[func_a];
    }
    else if(param_ptr==param_ptr_end[func_a]){
      param_ptr = 0;
      index_ab = 1;
      return 1;
    }
    else{
      param_ptr++;
    }
  }
  break;

case 7:     /* A&BSeparate, cw, flag_options=1 */
  if(param_ptr==OPTIONS_END){
    param_ptr = 0;
    flag_options = 0;
    return 1;
  }
  else{
    param_ptr++;
  }
  break;

case 8:     /* Ch A Only, ccw, flag_options=0 */
  if(param_ptr==0){
    param_ptr = OPTIONS_END;
    flag_options = 1;
  }
  else if(param_ptr==param_ptr_start[func_a]){
    param_ptr = 0;
    return 1;
  }
  else{
    param_ptr--;
  }
  break;

case 9:     /* Ch A Only, ccw, flag_options=1 */
  if(param_ptr==OPTIONS_START){
    param_ptr = param_ptr_end[func_a];
    flag_options = 0;
  }
  else{
    param_ptr--;
    if(param_ptr==OPTIONS_START){
      return 1;
    }
  }
  break;

case 10:    /* Ch A Only, cw, flag_options=0 */
  if(param_ptr==0){
    param_ptr = param_ptr_start[func_a];
  }
  else if(param_ptr==param_ptr_end[func_a]){
    param_ptr = OPTIONS_START;
    flag_options = 1;
    return 1;
  }
  else{
    param_ptr++;
  }
  break;

case 11:    /* Ch A Only, cw, flag_options=1 */
  if(param_ptr==OPTIONS_END){
    param_ptr = 0;
    flag_options = 0;
    return 1;
  }
  else{
    param_ptr++;
  }
  break;

default:
  break;
}   /* end switch */

return 0;
}


/**************************************************************************
 * inc_dec_mod (fix: posible shorter to use: "*ptr = ++(*ptr) % mod" for mod)
 * Increment/Decrement modulo mod based on cw
 **************************************************************************/
void inc_dec_mod(int *ptr, int mod)
{
if(mod){
  if(cw){
    ++(*ptr);
    if((*ptr)>=mod) *ptr = 0;
  }
  else{
    --(*ptr);
    if((*ptr)<0) *ptr = mod - 1;
  }
}
else{
  *ptr = 0;     /* if mod==0, return 0 */
}
}


/**************************************************************************
 * add_sub
 * Add/Subtract 10^pow to long based on cw (where: 0<=pow<=9)
 **************************************************************************/
void add_sub_pow(long *ptr, int pow)
{
long delta;

switch(pow){
case 0:
  delta = 1;
  break;
case 1:
  delta = 10;
  break;
case 2:
  delta = 100;
  break;
case 3:
  delta = 1000;
  break;
case 4:
  delta = 10000;
  break;
case 5:
  delta = 100000;
  break;
case 6:
  delta = 1000000;
  break;
case 7:
  delta = 10000000;
  break;
case 8:
  delta = 100000000;
  break;
case 9:
  delta = 1000000000;
  break;
default:
  delta = 1;
  break;
}

if(cw){
  (*ptr) += delta;
}
  else{
  (*ptr) -= delta;
}

if((*ptr)>max_value){
  (*ptr) = max_value;
}

if((*ptr)<min_value){
  (*ptr) = min_value;
}

}


/**************************************************************************
 * update_dsp
 * This function updates the DSP's function to reflect current parameter
 * values.
 *
 **************************************************************************/
void update_dsp(int param_ptr_tmp, int index_ab_tmp)
{
long ltemp;
int itemp, iorder, cursor_temp;
float f1, f2, fcenter, fwidth, ftemp;

/* Update the DSP's function: */
switch(param_ptr_tmp){
case 0: /* FUNC: */
  if(params_changed_copy==1) break; /* update only min_value and max_value */
  gain(index_ab_tmp);   /* Calculate setting of gain constant and output attenuator based on current func and index_ab_tmp */
  update_dsp(param_ptr_start[(int)params[0][index_ab_tmp]],index_ab_tmp);   /* Initialize the current function with recursive call */
  break;

case 1: /* Levels:In Out */
  assembly_flag |= 1;   /* flag the VU Meter to turn on */
  break;

case 2: /* RevertToLevels: */
  auto_vu_count = (int)params[2][0];    /* restart counter; set to 0 or 1 depending on RevertToLevels */
  break;

case 3: /* FullScalIn: */
  min_value = 1;    /* set min and max value to bound paramter */
  max_value = max_in_level;
  if(params_changed_copy==1) break; /* update only min_value and max_value */
  set_all_gains();      /* set optimal CODEC gains and attenuations */
  break;

case 4: /* SampleRate: */
  if(params_changed_copy==1) break; /* update only min_value and max_value */
  set_fsample();        /* set CODEC sampling rate */
  init_freq_params();   /* pull up factory default frequencies */
  /* no "break;"           fall into case 6: below to init functions: */

case 6: /* Mode: */
  if(params_changed_copy==1) break; /* update only min_value and max_value */
  /* Set the current function: */
  if(params[6][0]==0){  /* Mode:A&B Common */
    gain(2);    /* Calculate setting of gain constants and output attenuator based on current func */
    update_dsp(param_ptr_start[(int)params[0][2]],2);   /* Initialize the current function with recursive call */
  }
  else if(params[6][0]==1){ /* Mode:A&B Separate */
    if(params[17][0] > 128) params[17][0] = 127;    /* reset filter order to default if greater that 128 */
    if(params[20][0] > 128) params[20][0] = 127;
    if(params[26][0] > 128) params[26][0] = 127;
    if(params[32][0] > 128) params[32][0] = 127;
    if(params[40][0] > 128) params[40][0] = 127;
    gain(0);    /* Calculate setting of gain constant and output attenuator based on current func */
    update_dsp(param_ptr_start[(int)params[0][0]],0);   /* Initialize the current function with recursive call */
    gain(1);    /* Calculate setting of gain constant and output attenuator based on current func */
    update_dsp(param_ptr_start[(int)params[0][1]],1);   /* Initialize the current function with recursive call */
  }
  else{                 /* Mode:Ch A Only */
    func_addr_b = (unsigned)&no_func_b; /* set Ch B to no_func so Ch A can run long filter */
    gain(0);    /* Calculate setting of gain constant and output attenuator based on current func */
    update_dsp(param_ptr_start[(int)params[0][0]],0);   /* Initialize the current function with recursive call */
  }
  break;

case 5: /* InputSrc: */
  if(params_changed_copy==1) break; /* update only min_value and max_value */
  assembly_flag = (int)params[5][0] ? (assembly_flag|8):(assembly_flag&(~8));   /* set/clear the white noise flag for assembly code */
  break;

case 7: /* Cascade Ch A&B */
  if(params_changed_copy==1) break; /* update only min_value and max_value */
  assembly_flag = (int)params[7][0] ? (assembly_flag|4):(assembly_flag&(~4));   /* set/clear the cascade flag for assembly code */
  break;

case 8: /* Master Mode */
  if(params_changed_copy==1) break; /* update only min_value and max_value */

  break;

case 9: /* Erase Mem: */
  if(params_changed_copy==3){
    initialize();   /* initialize DSP hardware */
    wait(500000);   /* wait to display "FUNC:AllPass" */
    store_all();    /* store current settings to all flash memory locations */
    update_disp_left();     /* display parameter state */
    update_disp_right(1);
  }
  break;

case 10:    /* Store: */
  store();  /* store settings if params_changed_copy==3 */
  break;

case 11:    /* Recall: */
  recall(); /* recall settings if params_changed_copy==3 */
  break;

case 12:    /* Firmware:  V */
/*  portfff5 &= ~0x0200;    /* suspend delta interupts while updating display */
/*  if(params_changed_copy==1){ */
    disp_num(VERSION, 13, 4, 2);
    disp_text("", 1, 0);    /* position cursor home */
/*  }
  else if(params_changed_copy==2){
    disp_text("", 13, 0);   /* position cursor to 13 */
/*  } *
/*  portfff5 |= 0x0200;     /* re-enable delta interupts */
  break;

case 13:    /* Serial No: */
/*  portfff5 &= ~0x0200;    /* suspend delta interupts while updating display */
/*  if(params_changed_copy==1){ */
    disp_num(serial_number, 11, 6, 0);
    disp_text("", 1, 0);    /* position cursor home */
/*  }
  else if(params_changed_copy==2){
    disp_text("", 11, 0);   /* position cursor to 11 */
/*  } */
/*  portfff5 |= 0x0200;     /* re-enable delta interupts */
  break;
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
